JayChintala/1DOF-FOC-Force-Feedback/README.md

# 1DOF-FOC-Force-Feedback
This project aims to use a motor with FOC to find the force applied to it (ie. force feedback). It will then use a second motor to apply an equal force.
