JayChintala/1DOF-FOC-Force-Feedback/BOM.xlsx

ESC | DigiKey | https://www.digikey.com/en/products/detail/stmicroelectronics/B-G431B-ESC1/10321670 | 2 | $39.53 | $79.06
Magnetic Encoder | DigiKey | https://www.digikey.com/en/products/detail/ams-osram-usa-inc/AS5047P-ADAPTERBOARD/5452344 | 2 | $19.40 | $38.80
Motor | RCTimer | https://www.rctimer.com/rctimer-gbm2804-hollow-shaft-brushless-gimbal-motor-p0445.html | 3 | $10.94 | $32.82
USB-CAN Adapter | ODrive | https://shop.odriverobotics.com/products/usb-can-adapter | 1 | $37.00 | $37.00
Magnets | DigiKey | https://www.digikey.com/en/products/detail/radial-magnets-inc/8995/5126077 | 10 | $0.33 | $3.30
12V Power Supply | Amazon | https://www.amazon.com/Towisituati-100V-240V-Converter-Transformer-Connector/dp/B0F4X4J3SL | 1 | $20.00 | $20.00
Tariff Estimate | DigiKey |  | 1 | $18.71 | $18.71
Shipping | DigiKey |  | 1 | $6.99 | $6.99
Shipping + Tariff | ODrive |  | 1 | $14.53 | $14.53
Shipping + Tariff | RCTimer |  | 1 | $17.00 | $17.00
 |  |  |  | Total | $268.21
