JayChintala/1DOF-FOC-Force-Feedback/ESC_based/FIRMWARE_CHANGES.txt

FIRMWARE CHANGES FOR THE DEV MACHINE (ESC_based, both B-G431B-ESC1 boards)
Written 2026-10-25 on the Pi; CHANGE 3 added 2026-10-26.
Repo branch: tune/current-sensing-gain-16x.
Context and test results: ESC_based/software/TEST_LOG.md ("Firmware changes"
section near the top; the B1, "SD-card write stalls" and 2026-10-26 "leader
friction measurements" entries explain why).

===========================================================================
INSTRUCTIONS FOR THE CLAUDE CODE SESSION
===========================================================================

UPDATE 2026-10-28 (Pi, later): 75a893b (CHANGES 3-6) IS FLASHED on both
boards and verified on the bus (CALIB/DIAG present, switching calibration
used). NEXT ROUND = CHANGE 7 (below), same two-phase process.

UPDATE 2026-10-28 (Pi): CHANGES 3-6 are IMPLEMENTED and pushed by the dev
session (856a6bb = CHANGES 1-2 rebased, 75a893b = CHANGES 3-6; both builds
0 warnings). NOT YET FLASHED at the time of writing. Deviation from the
text below, approved by the user: the ch18 phase-C offset is exposed by an
accessor (OffsetCalib_GetPhaseCCh18), PolarizationOffsets_t is unchanged.
Images: Debug/ESC_based.elf (ESC1) sha256 49363e6a..84b6,
Debug_ESC2/ESC_based.elf (ESC2) sha256 72e80386..c23a.

STATUS (2026-10-28): CHANGES 1-3 are ALREADY APPLIED and flashed (1-2 on
2026-10-25, 3 on 2026-10-26; the CHANGE 3 edit is still uncommitted on the
dev machine). Check they are present -- do not apply them twice.

THIS ROUND: CHANGES 4, 5 and 6, in TWO PHASES:
  PHASE 1 (read-only): for CHANGE 5 and CHANGE 6, answer every "CHECK AND
    REPORT FIRST" item and propose the exact design/diff (including any
    MCSDK __weak overrides placed in user code). For CHANGE 4, confirm the
    frame layouts below fit the TX FIFO budget. Then STOP and report to
    the user. Do not edit yet.
  PHASE 2 (after the user approves the report): implement 4, 5 and 6, each
    behind its compile-time switch, build both ESC configurations
    warning-free for the edited files, report the diff + build result, and
    flash only when the user says so.
Do not change anything else.

HARD RULES
- Hand-edit the source files only. NEVER regenerate code from Motor Control
  Workbench / STM32CubeMX. The .ioc (ESC_based/STM32/MCWorkbench/MCWorkbench.ioc)
  still says PGA gain 8x; regenerating would revert the 16x current-sense gain
  and overwrite the hand-written FDCAN and coupling code.
- No other edits, refactors, or "while I'm here" fixes.
- Build both configurations the user flashes (ESC 1 with CAN_NODE_BASE 0x000 and
  ESC 2 with 0x020 -- however the project selects the node base; do not change
  that mechanism). The build must be warning-free for the edited files.
- Do not commit or push unless the user asks. If asked: branch is
  tune/current-sensing-gain-16x; end the commit message with the attribution
  line the user's setup requires.
- When done, report: the diff, build result (errors/warnings), and confirm
  both boards were flashed. The Pi session then verifies on hardware.

All paths below are relative to ESC_based/STM32/MCWorkbench/.

===========================================================================
CHANGE 1 (plan step B4): TELEM sends the 1 ms mean of Iq, not one raw sample
===========================================================================

WHY
The current loop samples Iq at 16 kHz, but TELEM (sent at 1 kHz) carries one
raw sample and discards the other 15. Measured on the Pi: that sample's noise
is 0.030-0.043 A std at rest, and a 16:1 decimation with no anti-alias filter
folds 500 Hz-8 kHz content into 0-500 Hz (a 247 Hz peak in the spectrum is
probably that). The firmware ALREADY accumulates all 16 samples every period
(IqTelem_UpdateHF / IqTelem_GetMeanAndReset in Src/mc_tasks_foc.c, raw s16A
units) and then throws the mean away. A 16-tap boxcar has nulls exactly at
1, 2, 3 ... kHz, where aliasing folds from. Expected: noise >= 2x lower,
aliased peak gone, ~0.5 ms extra delay at most. The TELEM byte layout does
not change, so the Pi needs no change.

FILE: STM32CubeIDE/Application/User/can_driver.c

(a) After the existing #include lines near the top (mc_parameters.h is already
    included there for scaleParams_M1), add:

    /* B4: TELEM Iq = mean of every 16 kHz sample since the previous TELEM
       (IqTelem_GetMeanAndReset, raw s16A, scaled to Amps). 0 = the old raw
       single sample MC_GetIqdMotor1_F().q. */
    #ifndef TELEM_IQ_MEAN
    #define TELEM_IQ_MEAN 1
    #endif

(b) In static void SendTelemetry(const CAN_TickSample_t* s)  (about line 409):

    DELETE this declaration (about line 413):
      qd_f_t iqd = MC_GetIqdMotor1_F(); /* .q = torque-producing current, .d = 0 in
                                           your control scheme */

    REPLACE the comment block and call (about lines 422-430) that begins
      /* The 16 kHz conditioned-Iq accumulator (IqTelem_UpdateHF) is still
    and ends with
      (void)IqTelem_GetMeanAndReset();
    WITH:

      /* The 16 kHz accumulator (IqTelem_UpdateHF) must be drained exactly once
         per telemetry period -- GetMeanAndReset clears it; left uncalled the
         sum grows without bound and loses float precision. With
         TELEM_IQ_MEAN its mean is what TELEM sends (B4): a 16-tap boxcar has
         nulls at 1, 2, 3 ... kHz, exactly where the 1 kHz decimation of the
         raw sample aliased from. It returns the EWMA if no samples accrued
         (HF task not running), so the field never reads as a bogus zero. */
    #if TELEM_IQ_MEAN
      float const iq_tx = IqTelem_GetMeanAndReset() * scaleParams_M1.current;
    #else
      (void)IqTelem_GetMeanAndReset();
      float const iq_tx = MC_GetIqdMotor1_F().q; /* raw single sample */
    #endif

    REPLACE (about line 440):
      memcpy(&payload[0], &iqd.q, sizeof(float));
    WITH:
      memcpy(&payload[0], &iq_tx, sizeof(float));

    Check that nothing else in SendTelemetry() uses `iqd` (it should not).

FILE: Inc/can_driver.h

(c) In the TELEM layout comment (about line 86), change
      [0..3] float32  Iq, Amps (MC_GetIqdMotor1_F().q -- raw, unfiltered)
    to
      [0..3] float32  Iq, Amps: 1 ms mean of the 16 kHz samples when
                      TELEM_IQ_MEAN (default, can_driver.c); raw single
                      sample MC_GetIqdMotor1_F().q when TELEM_IQ_MEAN is 0

===========================================================================
CHANGE 2 (safety): direct-mode host timeout 200 ms -> 20 ms
===========================================================================

WHY
In direct mode the firmware zeroes Iq if no SET_IQ arrives within
COUPLE_DIRECT_TIMEOUT_US. On the Pi, SD-card write stalls froze the host
control loop for up to 2 s (confirmed). During one such freeze the follower's
last command (-0.07 A) stayed applied for the full 200 ms and the free
follower spun 1.8 revolutions; teleop can command up to 1 A. Every ESC_based
host script resends SET_IQ at least every 10 ms (teleop/spin_test/a5 every
2 ms, plant_gain 1 ms, zero_iq_check 10 ms), so 20 ms does not trip in normal
use; a longer stall now zeroes the current (trip HOST_TIMEOUT) and the next
SET_IQ resumes. HOLD/PEER coupling modes have no host timeout and are not
affected.

FILE: Inc/couple_ctrl.h  (about line 113)

    CHANGE
      #define COUPLE_DIRECT_TIMEOUT_US 200000u
    TO
      #define COUPLE_DIRECT_TIMEOUT_US 20000u /* was 200000u; see FIRMWARE_CHANGES.txt */

    Leave the surrounding #ifndef/#endif and the comment above it as they are,
    except: if that comment states 200 ms anywhere, update it to 20 ms.
    (couple_ctrl.c uses the macro at about lines 265-267; no change there.)

===========================================================================
CHANGE 3 (2026-10-26): average the current-sensor offset calibration longer
===========================================================================

WHY
Measured on the Pi with a slow position sweep of the free leader
(friction_map.py): the leader has an angle-locked torque ripple at 7/rev
(once per electrical cycle) of 36 mA in one START and 24 mA, 13 deg shifted,
in the next. Everything else repeated (28/rev 10.1 vs 10.3 mA, friction
17.1 vs 16.8 mA). An electrical-frequency ripple that changes between STARTs
is the signature of a phase-current offset error: MCSDK re-measures the
offsets on every START (correction 2026-10-26 from the dev review: not via
MCI_StartMotor, but the "already calibrated" IDLE branch in mc_tasks_foc.c
still calls R3_2_CurrentReadingPolarization, which re-measures), and it
averages only NB_CONVERSIONS = 16 samples. With the measured 30-43 mA
per-sample noise that leaves roughly +-10 mA of random offset per phase,
new each START. 8x more samples -> about 2.8x smaller offset error.
It is the largest remaining feel defect on the leader (detents every 51 deg,
bigger than the 20 mA felt dead band), and a host-side map cannot cancel it
because it moves every START.

FILE: Inc/pwm_common.h  (line 37)

    CHANGE
      #define NB_CONVERSIONS 16u
    TO
      #define NB_CONVERSIONS 128u /* was 16u: offset calibration averaging; see FIRMWARE_CHANGES.txt CHANGE 3 */

CONSTRAINTS TO CHECK BEFORE BUILDING (report what you find for each)

(a) THE AVERAGING DIVISOR. The offsets are accumulated and divided in the
    R3_2 current-feedback driver, which is NOT in the git repo (MCSDK is
    git-ignored). The project links it from
      MCSDK_v6.4.2-Full/MotorControl/MCSDK/MCLib/G4xx/Src/r3_2_g4xx_pwm_curr_fdbk.c
    (see STM32CubeIDE/.project). Find where PhaseAOffset / PhaseBOffset /
    PhaseCOffset are summed (the HFCurrentsPolarization* functions) and
    where the sum is turned into the offset (CurrentReadingPolarization /
    the end of calibration).
      - If it divides by NB_CONVERSIONS (or by an expression of it), nothing
        else to change.
      - If it divides by a HARD-CODED shift or constant tied to 16 (e.g.
        ">> 4", ">> 3", "/ 16u", or a shift that assumes 16 samples per
        sector pass), STOP and report the exact lines to the user before
        changing anything. Do not guess the new shift: note that 3-shunt
        polarization may sum each phase over two sector passes, so the
        divisor may be 2*NB_CONVERSIONS.
      - Check the accumulator type: with 128 samples of a left-aligned
        16-bit ADC value (up to 65520) the sum reaches about 8.4e6, which
        needs uint32_t / int32_t (fine), not 16 bits. If it is 16-bit, STOP
        and report.
(b) THE COUNTER TYPE. PolarizationCounter is uint8_t (Src/mc_config.c line
    179, and waitForPolarizationEnd(..., volatile uint8_t *cnt) in
    Src/pwm_common.c). So NB_CONVERSIONS must stay <= 255. 128 is fine; do
    NOT use 256.
(c) THE TIMEOUT. Src/pwm_common.c waitForPolarizationEnd computes
      hMaxPeriodsNumber = (2 * NB_CONVERSIONS) * ((repCnt + 1) >> 1)
    as uint16_t. With 128 that is 256 * ((repCnt + 1) >> 1): check repCnt
    (the TIM1 repetition counter used by R3_2) keeps it below 65535 (it
    will unless repCnt is huge). No change expected.
(d) Search the whole build (Src, Inc, STM32CubeIDE/Application, and the
    linked MCSDK sources) for any other use of NB_CONVERSIONS and report it.

EXPECTED SIDE EFFECT
Offset calibration at START takes 8x longer: roughly 2 x 128 PWM periods at
16 kHz, i.e. about 16 ms instead of 2 ms. The Pi scripts wait for RUN, so
nothing on the Pi changes.

===========================================================================
CHANGE 4 (APPLY THIS ROUND -- see STATUS; logged 2026-10-26, frames fixed 2026-10-28)
Diagnostic CAN frames: CALIB (phase offsets) + DIAG (Vqd, sector, flags, NTC), 10 Hz
===========================================================================

WHY
The leader's 7/rev ripple has a fixed phase, grows over time in RUN and
survives a fresh START (TEST_LOG 2026-10-26). Calibration runs with all six
FETs off, while RUN samples mid-period with the low sides conducting.
Reading the offsets and the board NTC back per START, and checking whether
the ripple tracks temperature, separates the two candidate causes: (a) an
offset that exists only while the FETs conduct (calibration cannot see it),
or (b) a thermal offset drift after calibration. The Pi currently works
around the ripple with an in-session calibration sweep; this change is for
root cause. The DIAG frame also diagnoses the measured-Iq breakdown above
~0.5 A (angle-dependent, TEST_LOG 2026-10-28).

WHAT (as described by the dev-session review, 2026-10-26; verify before use)
- Offsets: MC_GetPolarizationOffsetsMotor1(PolarizationOffsets_t*)
  (mc_api.c:693-696). Returns false before the first calibration. Fields are
  int32_t but hold averages of left-aligned 16-bit ADC values, so they fit
  in uint16.
- Temperature: NTC_GetAvTemp_C(&TempSensor_M1) (ntc_temperature_sensor.c:197),
  int16 deg C, board NTC, updated in the safety task.
- FRAME LAYOUTS (fixed 2026-10-28; the Pi parser follows these exactly;
  little-endian like TELEM; transmit-only; outside the 0x20 node block like
  DBG; if a layout must change, report it so the Pi side matches):
  CALIB  ID 0x100 + base + 0x013  (0x113 / 0x133), 10 Hz
    [0..1] u16 offA       [2..3] u16 offB
    [4..5] u16 offC_ch12  [6..7] u16 offC_ch18 (0 when CHANGE 5 is off)
    Raw offsets as used in R3_2_GetPhaseCurrents (left-aligned ADC units).
  DIAG   ID 0x100 + base + 0x014  (0x114 / 0x134), 10 Hz (faster only if
         the TX budget allows; report the rate)
    [0..1] i16 Vqd.q (FOCVars[M1].Vqd.q, after circle limitation)
    [2..3] i16 Vqd.d
    [4]    u8  PWMC _Super.Sector after the sample-point setup
    [5]    u8  flags: bit0 = SECTOR_5 forced this period,
                      bit1 = circle limitation active this period,
                      bit2 = OFFSET_CALIB_SWITCHING (CHANGE 5) built in
    [6..7] i16 board NTC temperature, deg C (NTC_GetAvTemp_C)
  DIAG was added 2026-10-28 for the measured-Iq breakdown above ~0.5 A:
  the dev review called Vqd.q "the most useful single measurement" (a
  lasting shortfall means the Iq PI output hits a limit).
  The two frames can go out on alternate CAN_ControlTick slots (e.g. tick
  % 100 == 0 and == 50) to spread the TX load.
- Send: from CAN_ControlTick (can_driver.c:514), see slots above. The TX
  FIFO has 3 elements and TELEM + DBG use 2 per tick, so count drops the
  same way as s_telemTxDropCount.
- Pi side: a parser in ESC_based/software/can_interface.py (Pi session).
- Same hard rules as above: hand edit only, never regenerate.

===========================================================================
CHANGE 5 (APPLY THIS ROUND, design reported first -- see STATUS; logged 2026-10-28;
apply together with CHANGE 4, behind a compile-time switch)
Offset calibration with the bridge SWITCHING at 50 % duty (zero net current)
===========================================================================

WHY (Pi measurements, TEST_LOG 2026-10-28)
The leader's 7/rev torque ripple (an Iq error at the electrical frequency =
a phase-current offset error) grows while in RUN at ~0 A: 8.9 -> 22.3 mA in
89 s; in a 6 min run 18.5 -> 35 -> 50 -> 61 -> 57 mA, fit
17.6 + 47.9 (1 - e^(-t/160 s)) mA, always along the same phase. A fresh
START on a warm board starts at 18.5 mA (cold: 8.9 mA), so re-calibrating
does NOT remove it. Calibration runs with all six FETs off
(R3_2_CurrentReadingPolarization: LL_TIM_CC_DisableChannel CH1/2/3 + MOE,
OSSR), while RUN samples mid-period with the low-side FETs conducting.
Hypothesis (inferred): an offset that exists only while the bridge
switches and grows with board temperature, invisible to an all-off
calibration. Calibrating under the same switching conditions as RUN, with
equal duty on all three phases (no line-line voltage -> ~0 current), would
capture it. CHANGE 4's readback (offsets + NTC per START) tests this:
with CHANGE 5, a warm START should begin near the cold value, not higher.

WHAT (for the dev session to design and REPORT BEFORE EDITING; MCSDK files
are git-ignored, so record every edit exactly)
- In the R3_2 polarization path (r3_2_g4xx_pwm_curr_fdbk.c, around lines
  476-575 and R3_2_HFCurrentsPolarizationAB/C ~1343/~1392), instead of
  disabling CH1/2/3, program all three compare registers to 50 % of the
  period (Half_PWMPeriod/2 in the center-aligned counter, or whatever gives
  equal duty) and enable the outputs, so the bridge switches exactly as in
  RUN at zero voltage vector; keep the ADC trigger at the RUN mid-period
  point. Restore the normal sequence afterwards.
- Behind  #define OFFSET_CALIB_SWITCHING 1  (0 = stock all-off calibration)
  so it can be rolled back without code edits.
- CHECK AND REPORT FIRST:
  (a) Bootstrap: calibration currently happens BEFORE CHARGE_BOOT_CAP.
      With switching, the high-side drivers need charged bootstrap caps;
      decide whether to run CHARGE_BOOT_CAP first (reorder in
      mc_tasks_foc.c IDLE/OFFSET_CALIB/CHARGE_BOOT_CAP) or rely on the
      low-side on-time. Report the safer sequence.
  (b) Shaft must be still: equal duties give ~0 current only without
      back-EMF. START is only sent with the shaft at rest by the Pi
      scripts; note any firmware guard you would add (e.g. skip
      switching calibration if |speed| > small threshold).
  (c) Dead-time: equal on all three legs, so no net current expected;
      confirm nothing (e.g. sector-dependent sampling in
      R3_2_SetADCSampPointPolarization) breaks with outputs enabled.
  (d) Overcurrent/fault paths stay armed during calibration.
- Same hard rules: hand edit, never regenerate; report the diff and build
  result; do not flash until the user says so.

ADDED 2026-10-28: per-read-path phase-C offset (from the dev review).
Sectors 2-3 read C on ADC2 ch18 (OPAMP3 internal output) but subtract the
PhaseCOffset calibrated on ADC1 ch12 (r3_2.c:714). Fold into CHANGE 5:
calibrate one offset per (ADC, channel, OPAMP-output) path -- a, b, c_ch12,
c_ch18 -- via a third polarization pass with PolarizationSector = SECTOR_2,
using the __weak R3_2_CurrentReadingPolarization / R3_2_GetPhaseCurrents
overrides in user code (MCSDK copy untouched). PolarizationOffsets_t needs
a fourth field for Set/Get.
Pi evidence for this (2026-10-28, hand-held stall steps, TEST_LOG): the
measured-Iq breakdown is ANGLE-dependent -- onset ~0.55 A at electrical
42-67 deg, ~0.8 A at 144/323 deg, none up to 0.8 A at 258 deg (angles
relative to the encoder electrical zero) -- i.e. it tracks the
sector/sampling path, at lower current than the 0.9-1.0 A the review
estimated from Rs 5.29 ohm / 13 V (check the real Vbus and Rs).

VERIFY ON THE PI AFTER FLASHING (with CHANGE 4)
cal_repeat.py --n 5 --wait 60 cold, then again warm right after: with
CHANGE 5 the 7/rev at t=0 of the WARM run should be ~cold value and the
growth within a START smaller; CHANGE 4's NTC trace shows the temperature.

===========================================================================
CHANGE 6 (APPLY THIS ROUND, values reported first -- see STATUS; logged 2026-10-28)
SAFETY: revert the over-current threshold rescaling
===========================================================================

WHY (dev-session review 2026-10-28)
The OCP comparators (COMP1/2/4 vs DAC3, main.c:437-505) compare the OPAMP
INPUTS (PA1/PA7/PB0), i.e. BEFORE the PGA. The "x2 for 8x->16x" rescaling
of DAC_OCP_Threshold (16334, mc_parameters.c:165-168) therefore did not
keep the physical trip current the same -- it RAISED it.

WHAT
Restore DAC_OCP_Threshold to the value that gives the original physical
trip current (the pre-16x value, or recompute from the shunt and the
comparator input network). Report the old value, the new value and the
resulting physical trip current in amps before changing it.

===========================================================================
CHANGE 7 (NEXT ROUND -- approved by the user 2026-10-28; TWO PHASES as before:
report the design first, implement after approval, flash only when told)
Sampling timing for the measured-Iq breakdown above ~0.5 A, plus DIAG fixes
===========================================================================

WHY (Pi measurements on firmware 75a893b, TEST_LOG 2026-10-28)
Hand-held stall steps at a "bad" rotor angle (electrical ~70 deg), with the
new DIAG frame:

  cmd     measured Iq mean (std)   Vq % of full   SECTOR_5 forced (snapshot)
  0.30 A  0.296 (15 mA)            21 %           100 %
  0.45 A  0.443 (18 mA)            29 %           100 %
  0.60 A  0.581 (52 mA)            55 %            71 %
  0.80 A  0.683 (111 mA)           70 %            56 %  (sectors 4, 5)

- The ch18 phase-C offset is now calibrated separately (CALIB shows it
  was 62-76 counts = 114-140 mA off), yet the breakdown is unchanged, and
  at 0.6 A the read is still mostly forced A+B (no ch18). So the ch18
  path is not the cause.
- Vq jumps 29 -> 55 % between 0.45 and 0.6 A (R*I alone: ~39 %): the PI
  over-drives against a measurement that reads low; scale data earlier
  showed the real current overshoots the command (~0.93 A at 0.8 A).
- The breakdown is angle-dependent (onset ~0.55 A at 42-70 deg, ~0.8 A at
  144/323 deg, none to 0.8 A at 258 deg).
- This matches the dev review's sampling-window hypothesis [inferred]: in
  forced SECTOR_5 the A and B samples are taken at Half_PWMPeriod - 1,
  and the time from the highest-duty leg's low-side turn-on to the
  sample shrinks as duty rises (~10 us at 0.45 A, ~7-8 us at 0.68 A real);
  if the sense front end needs longer to settle, the sample reads low.
  It only bites when that highest-duty leg is A or B (sampled), hence the
  angle dependence. The forced-mode test uses Tafter = (750 + 4000 ns) x
  0.17 = 807 counts (parameters_conversion.h:137-140), i.e. it assumes
  ~4.75 us is enough.

WHAT (design to report first)
(a) Make the forced-SECTOR_5 threshold Tafter adjustable WITHOUT
    regenerating: preferably at RUNTIME via a new Pi->MCU CAN command
    (proposed: base+0x007 SET_PARAM, uint8 param id + int32/float value;
    param 1 = Tafter in timer counts, accepted only within e.g. 400..3000
    counts, applied in IDLE or atomically per PWM period -- report which
    is safe), so the Pi can sweep it in one session (stock 807, then e.g.
    ~1360 = 8 us, ~2040 = 12 us) without reflashing. Report whether
    pParams_str->Tafter is const/in flash and what it takes to make it a
    RAM variable used by R3_2_SetADCSampPointSectX (r3_2.c:1134) and any
    other user of Tafter/Tbefore. If a runtime parameter is not
    reasonable, fall back to a compile-time #define SAMPLING_TAFTER_NS
    and report the build matrix.
    Also report: with forced mode ending earlier, which phases does the
    natural-sector path sample (it should be the two lowest-duty legs,
    i.e. longest windows), and is anything else in that path suspect now
    that the ch18 offset is calibrated?
(b) Fix the DIAG flag bits (from Pi data on 75a893b):
    - bit1 "circle limit seen" is set 96-100 % of DIAG frames even at
      0.05 A with Vq ~6 % of full -- impossible; check the |Vqd|^2 test
      (overflow? computed on the wrong variable or including the
      calibration / IDLE periods?).
    - bit3 "non-forced seen" is 100 % at every level while the bit0
      snapshot shows forced 100 %; bit4 "ch18 seen" is 52 % at 0.05 A,
      falling to 0 % at 0.45 A. Check when the sticky bits are set
      (e.g. periods where PWM is on but outside RUN, or the test
      inverted) and fix so they reflect RUN sampling only.
(c) Report the Vq value the PI requests vs the circle-limited Vq (if the
    DIAG Vq is post-limitation, add the pre-limitation value to the spare
    bits or a 3rd frame only if cheap -- optional).
(d) NOT this round, note only: the leader's 7/rev ripple (an Iq error at
    the electrical frequency) still grows in RUN with the switching
    calibration (11 -> 55 mA in 89 s, NTC 34 -> 40 C), so it is most
    likely offset drift with board temperature AFTER calibration. A later
    change could apply offset(T) = offset_cal + k_phase * (NTC - NTC_cal),
    with k measured on the Pi from repeated START/STOP CALIB readbacks.
Same hard rules: hand edits only, never regenerate; compile-time switch
for each part; both builds warning-free; report diff, build result and
image checksums; commit and push after a clean build; do not flash until
the user says so. Report any SET_PARAM layout change so the Pi side
matches.

VERIFY ON THE PI
Stall steps at a bad angle (~70 deg electrical) for each Tafter value,
with DIAG: pass = measured Iq within 2 % of command up to 0.8 A with std
<= 25 mA, Vq roughly proportional to current, SECTOR_5 forced ending
earlier; then the scale check (force linear to 0.8 A at ~1.044 N/A).

===========================================================================
NOT INCLUDED (decided by the user)
===========================================================================
- B5, clamping direct SET_IQ at +-0.8 A, was DROPPED by the user, who says a
  max current is already set. Do not add a clamp.

===========================================================================
AFTER FLASHING (done on the Pi, for reference)
===========================================================================
CHANGE 3: bus_check.py, zero_iq_check.py, then two friction_map.py --node B
sweeps with a START between. Pass: 7/rev amplitude well below 24-36 mA
(target <= 12 mA) and repeatable between the two STARTs (|diff| <= 5 mA);
28/rev and friction unchanged. Then refit leader_comp_B.json, now including
7/rev if it repeats.

Earlier changes (1-2), already verified 2026-10-25:
Both boards will power-cycle, so the Pi's bus_check.py shows RESET. The Pi
session then runs zero_iq_check.py (re-aligns the encoders), and the B4
checks: a 30 s HOLD zero-gain run on the free follower (Iq std >= 2x lower
than 0.030-0.034 A, 247 Hz peak gone) and the A5(c) staircase (50 % step
response <= 2.07 ms). Nothing for the dev-machine session to do there.
