JayChintala/1DOF-FOC-Force-Feedback/electrical-schematic/1DOF_FOC_Force-Feedback.kicad_pcb

## KiCad design c4-taillight-controller/mcu.kicad_sch

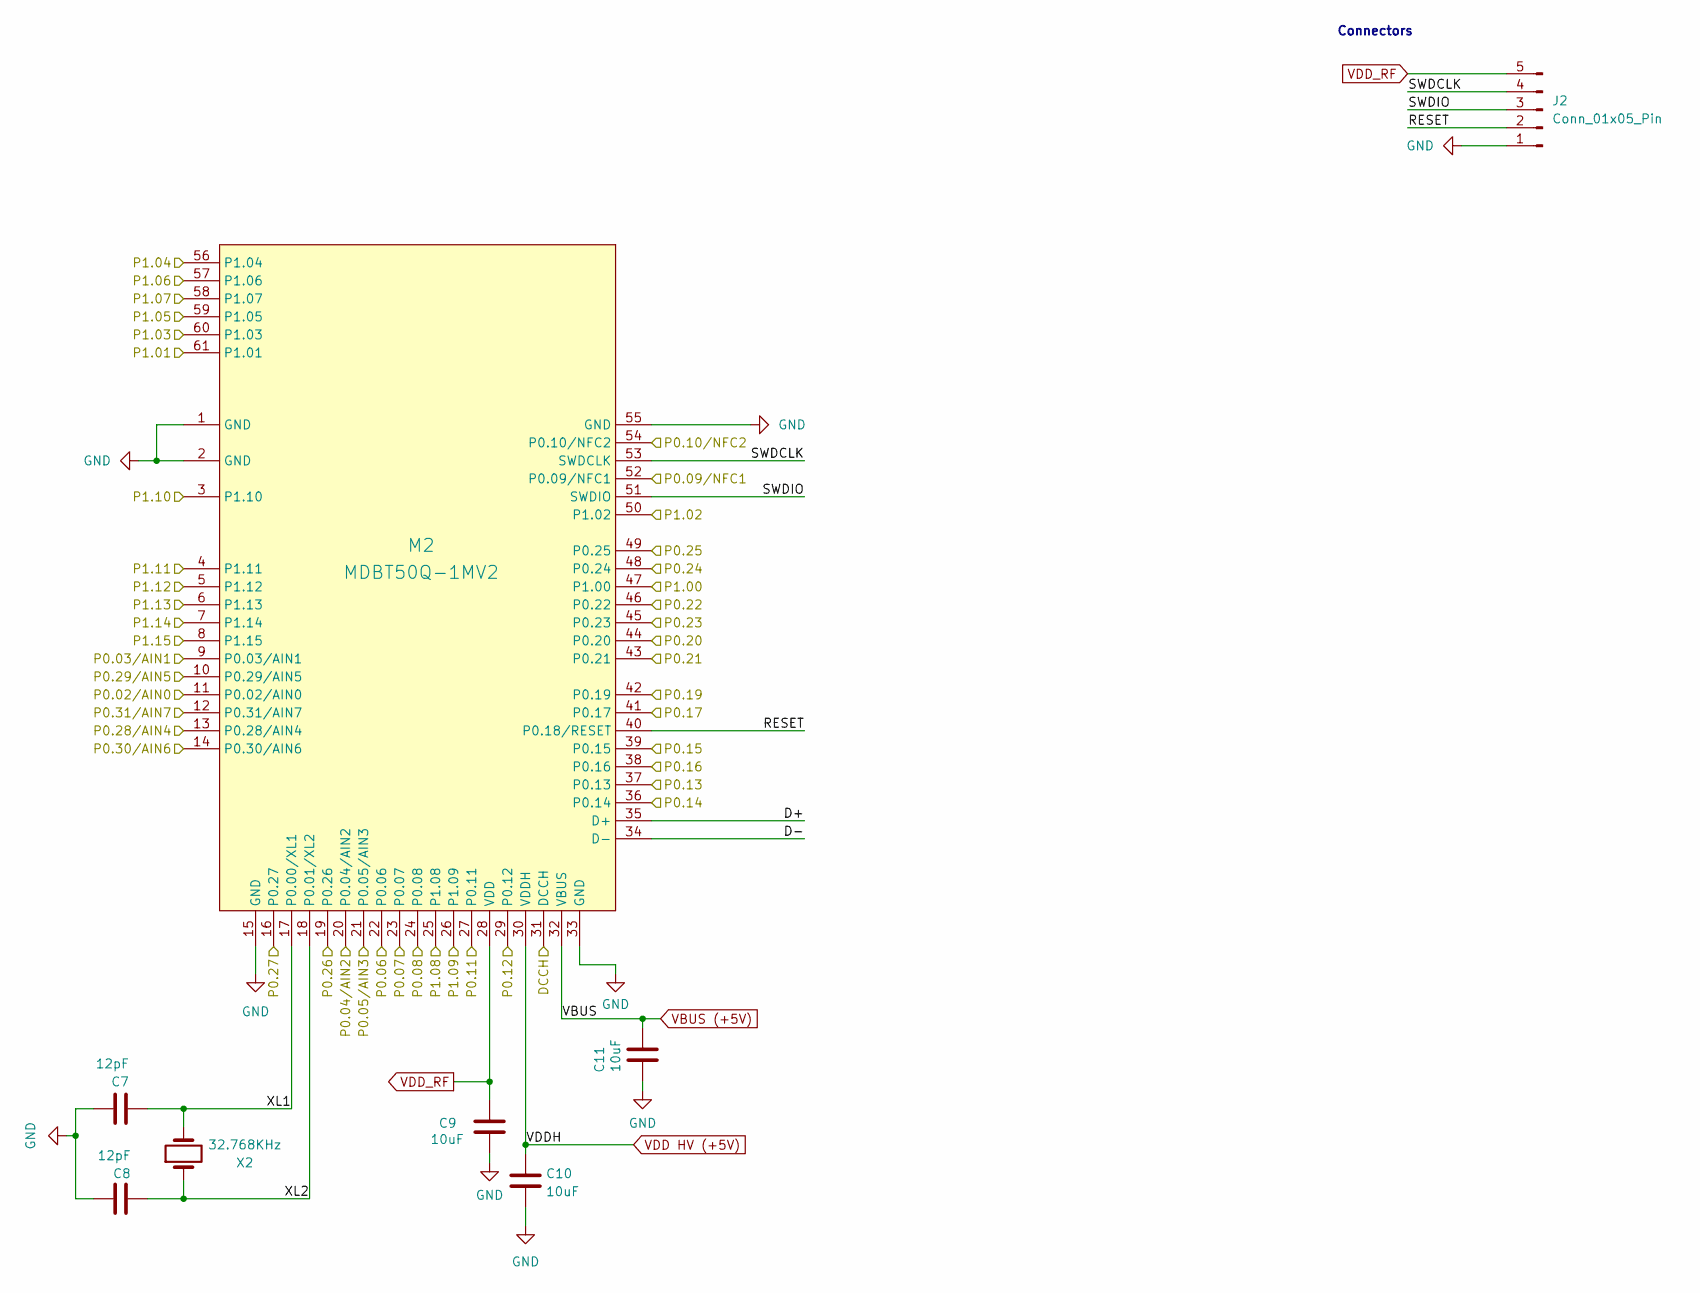
[picture p1: schematic mcu.kicad_sch]

Parts:
C7, C8: 12pF
C9, C10, C11: 10uF
J2: Conn_01x05_Pin
M2: MDBT50Q-1MV2
X2: 32.768KHz

Connections:
D+: M2.35 (D+)
D-: M2.34 (D-)
DCCH: M2.31 (DCCH)
GND: C7.1, C8.1, C9.1, C10.2, C11.1, J2.1, M2.1 (GND), M2.2 (GND), M2.15 (GND), M2.33 (GND), M2.55 (GND)
P0.02/AIN0: M2.11 (P0.02/AIN0)
P0.03/AIN1: M2.9 (P0.03/AIN1)
P0.04/AIN2: M2.20 (P0.04/AIN2)
P0.05/AIN3: M2.21 (P0.05/AIN3)
P0.06: M2.22 (P0.06)
P0.07: M2.23 (P0.07)
P0.08: M2.24 (P0.08)
P0.09/NFC1: M2.52 (P0.09/NFC1)
P0.10/NFC2: M2.54 (P0.10/NFC2)
P0.11: M2.27 (P0.11)
P0.12: M2.29 (P0.12)
P0.13: M2.37 (P0.13)
P0.14: M2.36 (P0.14)
P0.15: M2.39 (P0.15)
P0.16: M2.38 (P0.16)
P0.17: M2.41 (P0.17)
P0.19: M2.42 (P0.19)
P0.20: M2.44 (P0.20)
P0.21: M2.43 (P0.21)
P0.22: M2.46 (P0.22)
P0.23: M2.45 (P0.23)
P0.24: M2.48 (P0.24)
P0.25: M2.49 (P0.25)
P0.26: M2.19 (P0.26)
P0.27: M2.16 (P0.27)
P0.28/AIN4: M2.13 (P0.28/AIN4)
P0.29/AIN5: M2.10 (P0.29/AIN5)
P0.30/AIN6: M2.14 (P0.30/AIN6)
P0.31/AIN7: M2.12 (P0.31/AIN7)
P1.00: M2.47 (P1.00)
P1.01: M2.61 (P1.01)
P1.02: M2.50 (P1.02)
P1.03: M2.60 (P1.03)
P1.04: M2.56 (P1.04)
P1.05: M2.59 (P1.05)
P1.06: M2.57 (P1.06)
P1.07: M2.58 (P1.07)
P1.08: M2.25 (P1.08)
P1.09: M2.26 (P1.09)
P1.10: M2.3 (P1.10)
P1.11: M2.4 (P1.11)
P1.12: M2.5 (P1.12)
P1.13: M2.6 (P1.13)
P1.14: M2.7 (P1.14)
P1.15: M2.8 (P1.15)
RESET: J2.2, M2.40 (P0.18/RESET)
SWDCLK: J2.4, M2.53 (SWDCLK)
SWDIO: J2.3, M2.51 (SWDIO)
VBUS (+5V): C11.2, M2.32 (VBUS)
VDD HV (+5V): C10.1, M2.30 (VDDH)
VDD_RF: C9.2, J2.5, M2.28 (VDD)
XL1: C7.2, M2.17 (P0.00/XL1), X2.2
XL2: C8.2, M2.18 (P0.01/XL2), X2.1

Notes on the sheet:
Connectors
