JayChintala/1DOF-FOC-Force-Feedback/electrical-schematic/1DOF_FOC_Force-Feedback.kicad_pcb

## KiCad design c4-taillight-controller/power.kicad_sch

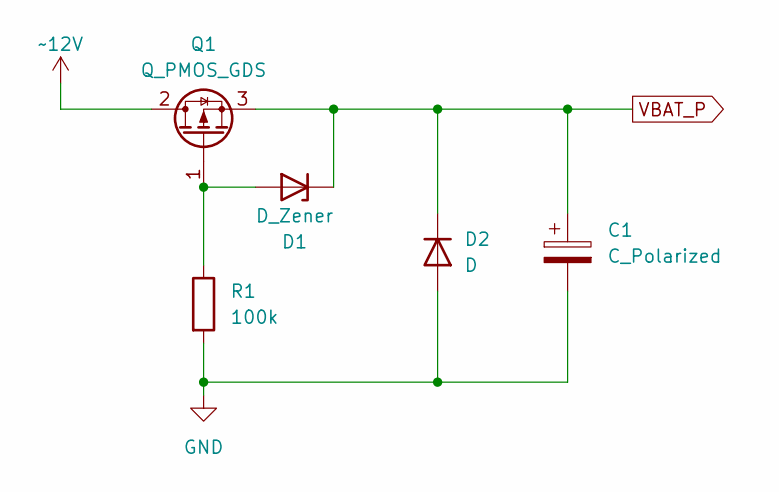
[picture p2: schematic power.kicad_sch]

Parts:
C1: C_Polarized
D1: D_Zener
D2: D
Q1: Q_PMOS_GDS
R1: 100k

Connections:
GND: C1.2, D2.2 (A), R1.2
unnamed: D1.2 (A), Q1.1 (G), R1.1
VBAT_P: C1.1, D1.1 (K), D2.1 (K), Q1.3 (S)
~12V: Q1.2 (D)
