JayChintala/1DOF-FOC-Force-Feedback/ESC_based/STM32/MCWorkbench/MCWorkbench.ioc

Mcu.UserName=STM32G431CBUx
PA0.GPIO_Label=M1_BUS_VOLTAGE
PA0.Signal=ADC1_IN1
PA1.GPIO_Label=M1_CURR_SHUNT_U
PA1.Signal=SharedAnalog_PA1
PA10.GPIO_Label=M1_PWM_WH
PA10.Signal=S_TIM1_CH3
PA11.Signal=FDCAN1_RX
PA12.GPIO_Label=M1_PWM_VL
PA12.Signal=TIM1_CH2N
PA2.GPIO_Label=M1_OPAMP1_OUT
PA2.Signal=SharedAnalog_PA2
PA3.GPIO_Label=M1_OPAMP1_INT_GAIN
PA3.Signal=OPAMP1_VINM0
PA5.GPIO_Label=M1_OPAMP2_INT_GAIN
PA5.Signal=OPAMP2_VINM0
PA6.GPIO_Label=M1_OPAMP2_OUT
PA6.Signal=SharedAnalog_PA6
PA7.GPIO_Label=M1_CURR_SHUNT_V
PA7.Signal=SharedAnalog_PA7
PA8.GPIO_Label=M1_PWM_UH
PA8.Signal=S_TIM1_CH1
PA9.GPIO_Label=M1_PWM_VH
PA9.Signal=S_TIM1_CH2
PB0.GPIO_Label=M1_CURR_SHUNT_W
PB0.Signal=SharedAnalog_PB0
PB1.GPIO_Label=M1_OPAMP3_OUT
PB1.Signal=SharedAnalog_PB1
PB13.GPIO_Label=CAN_TERM_ALT
PB13.Signal=GPIO_Output
PB14.GPIO_Label=M1_TEMPERATURE
PB14.Signal=ADC1_IN5
PB15.GPIO_Label=M1_PWM_WL
PB15.Signal=TIM1_CH3N
PB2.GPIO_Label=M1_OPAMP3_INT_GAIN
PB2.Signal=OPAMP3_VINM0
PB3.GPIO_Label=UART_TX
PB3.Signal=USART2_TX
PB4.GPIO_Label=UART_RX
PB4.Signal=USART2_RX
PB6.GPIO_Label=M1_ENCODER_A
PB6.Signal=S_TIM4_CH1
PB7.GPIO_Label=M1_ENCODER_B
PB7.Signal=S_TIM4_CH2
PB9.Signal=FDCAN1_TX
PC10.GPIO_Label=Start/Stop [PushButton]
PC10.Signal=GPXTI10
PC11.GPIO_Label=CAN_SHDN
PC11.Signal=GPIO_Output
PC13.Signal=TIM1_CH1N
PC14-OSC32_IN.GPIO_Label=CAN_TERM
PC14-OSC32_IN.Signal=GPIO_Output
PF0-OSC_IN.Signal=RCC_OSC_IN
PF1-OSC_OUT.Signal=RCC_OSC_OUT
