JayChintala/1DOF-FOC-Force-Feedback/ESC_based/STM32/MCWorkbench/Src/mc_tasks_foc.c

/**
  ******************************************************************************
  * @file    mc_tasks_foc.c
  * @author  Motor Control SDK Team, ST Microelectronics
  * @brief   This file implements tasks definition
  *
  ******************************************************************************
  * @attention
  *
  * <h2><center>&copy; Copyright (c) 2026 STMicroelectronics.
  * All rights reserved.</center></h2>
  *
  * This software component is licensed by ST under Ultimate Liberty license
  * SLA0044, the "License"; You may not use this file except in compliance with
  * the License. You may obtain a copy of the License at:
  *                             www.st.com/SLA0044
  *
  ******************************************************************************
  * @ingroup MCTasksFOC
  */

/* Includes ------------------------------------------------------------------*/
//cstat -MISRAC2012-Rule-21.1
#include "main.h"
//cstat +MISRAC2012-Rule-21.1
#include "mc_type.h"
#include "mc_math.h"
#include "motorcontrol.h"
#include "regular_conversion_manager.h"
#include "mc_interface.h"
#include "digital_output.h"
#include "pwm_common.h"
#include "mc_tasks.h"
#include "parameters_conversion.h"
#include "mcp_config.h"
#include "mc_app_hooks.h"

/** @addtogroup MCSDK
  * @{
  */

 /** @defgroup ConvFOC Conventional FOC
  *
  * @brief
  *
  * @{
  */

  /** @defgroup MCCockpit MC Cockpit
  *
  * @brief
  *
  * @{
  */

/** @addtogroup ConvFOC
  * @{
  */

/** @addtogroup	MCCockpit
  * @{
  */

/** @addtogroup	MCTasksFOC
  * @{
  */

/** @defgroup MCTasksFOC Motor Control Tasks for FOC
  *
  * @brief FOC legacy Motor Control subsystem configuration and operation routines.
  *
  * @{
  */

/* USER CODE BEGIN Private define */

/* USER CODE END Private define */


static volatile uint16_t hBootCapDelayCounterM1 = ((uint16_t)0);
static volatile uint16_t hStopPermanencyCounterM1 = ((uint16_t)0);

/* USER CODE BEGIN Private Variables */

/* ---- Iq telemetry conditioning (FLASH 1: telemetry only) ------------------
 * Fed from FOC_HighFrequencyTask at 16 kHz, drained by CAN_SendTelemetry()
 * at 1 kHz (SPEED_LOOP_FREQUENCY_HZ). Nothing here feeds the current PI
 * loop: FOCVars[M1].Iqd is read, never written, so control behaviour is
 * bit-for-bit unchanged. This exists to make the CAN telemetry a trustworthy
 * instrument before any control change is attempted.
 *
 * WHY: CAN_SendTelemetry() samples the 16 kHz Iq once per millisecond and
 * drops the other 15 samples. That is a 16:1 decimation with no anti-alias
 * filter, so everything from 500 Hz to 8 kHz folds down into the 0-500 Hz
 * band being plotted. Two conditioned variants are published alongside the
 * untouched raw sample so the three can be compared in a single run:
 *
 *   EWMA  - single pole, alpha 0.05, -3 dB at ~131 Hz. Matches PropHand's
 *           ALPHA_CURRENT_DQ. This is the variant worth promoting into the
 *           control loop later; only ~-12 dB at the 500 Hz fold point.
 *   MEAN  - boxcar average of every sample since the last telemetry send.
 *           A 16-tap boxcar has nulls at exactly 1 kHz, 2 kHz, ... which is
 *           precisely where aliasing folds from, so this is the better
 *           instrument for answering "is the noise real or aliased?".
 *
 * Units are raw s16A (same as FOCVars[].Iqd.q); can_driver.c scales to Amps
 * via scaleParams_M1.current so there is no second place to update when
 * AMPLIFICATION_GAIN changes. */
#define IQ_TELEM_EWMA_ALPHA 0.05f

static volatile float    s_iqTelemEwma     = 0.0f;
static volatile float    s_iqTelemAccum    = 0.0f;
static volatile uint32_t s_iqTelemAccumCnt = 0u;

/* ---- DIAG frame snapshot (CHANGE 4, FIRMWARE_CHANGES.txt) ------------------
 * Written at 16 kHz by Diag_UpdateHF() right after FOC_CurrControllerM1(),
 * drained by can_driver.c's DIAG send (10 Hz). Telemetry only: nothing here
 * is read by the control loop. Vqd is packed into one word so the 1 kHz
 * reader can never pair a q from one cycle with a d from another. */
#include "can_driver.h" /* CAN_DIAG_FLAG_*, CAN_DiagSample_t */
#include "sampling_tafter.h" /* CHANGE 7(a): the sampling callback and Tafter in use */

#if SAMPLING_TAFTER_RUNTIME
#define DIAG_SAMPLING_CB (&Sampling_SetADCSampPointSectX)
#else
#define DIAG_SAMPLING_CB (&R3_2_SetADCSampPointSectX)
#endif

static volatile uint32_t s_diagVqd    = 0u; /* Vqd.q in bits 0..15, Vqd.d in 16..31 */
static volatile uint8_t  s_diagSector = 0u;
static volatile uint8_t  s_diagFlags  = 0u; /* CAN_DIAG_FLAG_* bits 0, 1, 3, 4 */

#if CAN_DIAG2_FRAME
/* CHANGE 7(c): DIAG2. s_diagVqReq is the Iq PI output BEFORE circle
   limitation, stored by the one-line hand edit in FOC_CurrControllerM1().
   The counts are RUN periods since the previous DIAG2, saturating. */
static volatile int16_t  s_diagVqReq        = 0;
static volatile uint16_t s_diag2CircleCnt   = 0u;
static volatile uint16_t s_diag2NonForcedCnt = 0u;
#endif

/* USER CODE END Private Variables */

void TSK_MediumFrequencyTaskM1(void);
void FOC_InitAdditionalMethods(uint8_t bMotor);
void FOC_CalcCurrRef(uint8_t bMotor);
void TSK_MF_StopProcessing(uint8_t motor);

MCI_Handle_t *GetMCI(uint8_t bMotor);
static uint16_t FOC_CurrControllerM1(void);

void TSK_SafetyTask_PWMOFF(uint8_t motor);

/* USER CODE BEGIN Private Functions */

/* Declared in can_driver.h -- see the note there about why the telemetry
 * accessors are declared by the consumer rather than by a header of their
 * own (avoiding a new source file that would need adding to the build). */

/* Called from FOC_HighFrequencyTask at 16 kHz, after FOC_CurrControllerM1()
 * has published FOCVars[M1].Iqd. Runs in the ADC ISR: keep it branch-free
 * and FPU-only. */
void IqTelem_UpdateHF(int16_t iq_s16)
{
  float const iq = (float)iq_s16;

  /* Local read-modify-write so the volatile is touched once each way. */
  float ewma = s_iqTelemEwma;
  ewma += IQ_TELEM_EWMA_ALPHA * (iq - ewma);
  s_iqTelemEwma = ewma;

  s_iqTelemAccum    = s_iqTelemAccum + iq;
  s_iqTelemAccumCnt = s_iqTelemAccumCnt + 1u;
}

/* Single aligned 32-bit load -- atomic against the ISR on Cortex-M4, so no
 * masking needed here. */
float IqTelem_GetEwma(void)
{
  return s_iqTelemEwma;
}

/* Sum and count must be snapshotted and cleared together, so this one does
 * need the ISR held off. Costs the HF task a few cycles of jitter at 1 kHz.
 * Returns the EWMA if no samples accrued (motor stopped, HF task not
 * running) so the field never reads as a bogus zero. */
float IqTelem_GetMeanAndReset(void)
{
  uint32_t const primask = __get_PRIMASK();
  __disable_irq();

  float    const sum = s_iqTelemAccum;
  uint32_t const cnt = s_iqTelemAccumCnt;
  s_iqTelemAccum    = 0.0f;
  s_iqTelemAccumCnt = 0u;

  __set_PRIMASK(primask);

  return (cnt > 0u) ? (sum / (float)cnt) : s_iqTelemEwma;
}

/* Called from FOC_HighFrequencyTask at 16 kHz, after FOC_CurrControllerM1()
 * has run PWMC_SetPhaseVoltage(), so _Super.Sector is the read path the
 * NEXT period's R3_2_GetPhaseCurrents() will use. The path flags are only
 * updated while the normal sampling callback is installed with the PWM on,
 * i.e. not during offset calibration (which forces its own sectors). */
void Diag_UpdateHF(void)
{
  qd_t const v = FOCVars[M1].Vqd;
  s_diagVqd = (uint32_t)(uint16_t)v.q | ((uint32_t)(uint16_t)v.d << 16);

  PWMC_R3_2_Handle_t const *const h = &PWM_Handle_M1;
  bool const sampling = h->_Super.PWMState &&
      (h->_Super.pFctSetADCSampPointSectX == DIAG_SAMPLING_CB);
  /* CHANGE 7(b): PWM-on periods outside RUN (encoder ALIGNMENT on the first
     START after reset) no longer reach the flags. */
  bool const run = (RUN == Mci[M1].State);
#if DIAG_FLAGS_RUN_ONLY
  bool const flagsOn = sampling && run;
#else
  bool const flagsOn = sampling;
#endif

  if (sampling)
  {
    /* The exact test the sampling callback just made. */
    bool const forced =
        (uint16_t)(h->Half_PWMPeriod - h->_Super.lowDuty) > Sampling_GetTafter();

    /* Circle_Limitation() puts a limited vector on the circle, short only by
       its integer square-root truncation, so |Vqd|^2 >= M^2 - 2M catches
       every limited period (and only vectors within ~1 LSB of the circle
       otherwise). */
    int32_t const m = (int32_t)CircleLimitationM1.MaxModule;
    int32_t const sq = ((int32_t)v.q * v.q) + ((int32_t)v.d * v.d);
    bool const limited = (sq >= ((m * m) - (2 * m)));

    if (flagsOn)
    {
      uint8_t const sector = h->_Super.Sector;
      /* bit0 is a snapshot of this period; the others are sticky. */
      uint8_t f = s_diagFlags & (uint8_t)~CAN_DIAG_FLAG_SECTOR5_FORCED;
      f |= forced ? CAN_DIAG_FLAG_SECTOR5_FORCED : CAN_DIAG_FLAG_NONFORCED_SEEN;
      if ((SECTOR_2 == sector) || (SECTOR_3 == sector))
      {
        f |= CAN_DIAG_FLAG_CH18_SEEN;
      }
      if (limited)
      {
        f |= CAN_DIAG_FLAG_CIRCLE_SEEN;
      }
      s_diagSector = sector;
      s_diagFlags = f;
    }

#if CAN_DIAG2_FRAME
    /* DIAG2 counts RUN periods only, whatever DIAG_FLAGS_RUN_ONLY says. */
    if (run)
    {
      if (limited && (s_diag2CircleCnt < UINT16_MAX))
      {
        s_diag2CircleCnt++;
      }
      if (!forced && (s_diag2NonForcedCnt < UINT16_MAX))
      {
        s_diag2NonForcedCnt++;
      }
    }
#endif
  }
}

#if CAN_DIAG2_FRAME
/* Snapshot for the DIAG2 frame; clears the counts, so call it exactly once
 * per DIAG2. */
void Diag2_GetAndReset(CAN_Diag2Sample_t *out)
{
  uint32_t const primask = __get_PRIMASK();
  __disable_irq();

  out->vq_req = s_diagVqReq;
  out->circle_cnt = s_diag2CircleCnt;
  out->nonforced_cnt = s_diag2NonForcedCnt;
  s_diag2CircleCnt = 0u;
  s_diag2NonForcedCnt = 0u;

  __set_PRIMASK(primask);
}
#endif

/* Snapshot for the DIAG frame; clears the sticky flags, so it must be called
 * exactly once per DIAG. Holds the ISR off for a few cycles. */
void Diag_GetAndReset(CAN_DiagSample_t *out)
{
  uint32_t const primask = __get_PRIMASK();
  __disable_irq();

  uint32_t const vqd = s_diagVqd;
  out->sector = s_diagSector;
  out->flags = s_diagFlags;
  s_diagFlags = 0u;

  __set_PRIMASK(primask);

  out->vq = (int16_t)(uint16_t)(vqd & 0xFFFFu);
  out->vd = (int16_t)(uint16_t)(vqd >> 16);
}

/* USER CODE END Private Functions */
/**
  * @brief  It initializes the whole MC core according to user defined
  *         parameters.
  */
__weak void FOC_Init(void)
{

    /**********************************************************/
    /*    PWM and current sensing component initialization    */
    /**********************************************************/
    pwmcHandle[M1] = &PWM_Handle_M1._Super;
    R3_2_Init(&PWM_Handle_M1);

    /******************************************************/
    /*   PID component initialization: speed regulation   */
    /******************************************************/
    PID_HandleInit(&PIDSpeedHandle_M1);

    /******************************************************/
    /*   Main speed sensor component initialization       */
    /******************************************************/
    ENC_Init (&ENCODER_M1);

    /******************************************************/
    /*   Main encoder alignment component initialization  */
    /******************************************************/
    EAC_Init(&EncAlignCtrlM1,pSTC[M1],&VirtualSpeedSensorM1,&ENCODER_M1);
    pEAC[M1] = &EncAlignCtrlM1;

    /******************************************************/
    /*   Speed & torque component initialization          */
    /******************************************************/
    STC_Init(pSTC[M1],&PIDSpeedHandle_M1, &ENCODER_M1._Super);

    /********************************************************/
    /*   PID component initialization: current regulation   */
    /********************************************************/
    PID_HandleInit(&PIDIqHandle_M1);
    PID_HandleInit(&PIDIdHandle_M1);

    /*************************************************/
    /*   Power measurement component initialization  */
    /*************************************************/
    pMPM[M1]->pVBS = &(BusVoltageSensor_M1._Super);
    pMPM[M1]->pFOCVars = &FOCVars[M1];

    pREMNG[M1] = &RampExtMngrHFParamsM1;
    REMNG_Init(pREMNG[M1]);

    FOC_Clear(M1);
    STC_Clear(pSTC[M1]);
    FOCVars[M1].bDriveInput = EXTERNAL;
    FOCVars[M1].Iqdref = STC_GetDefaultIqdref(pSTC[M1]);
    FOCVars[M1].UserIdref = STC_GetDefaultIqdref(pSTC[M1]).d;

    MCI_ExecTorqueRamp(&Mci[M1], STC_GetDefaultIqdref(pSTC[M1]).q, 0);

}

/**
 * @brief Performs stop process and update the state machine.This function
 *        shall be called only during medium frequency task.
 */
void TSK_MF_StopProcessing(uint8_t motor)
{
  R3_2_SwitchOffPWM(pwmcHandle[motor]);

  FOC_Clear(motor);
  STC_Clear(pSTC[motor]);

  TSK_SetStopPermanencyTimeM1(STOPPERMANENCY_TICKS);
  Mci[motor].State = STOP;
}

/**
  * @brief Executes medium frequency periodic Motor Control tasks
  *
  * This function performs some of the control duties on Motor 1 according to the
  * present state of its state machine. In particular, duties requiring a periodic
  * execution at a medium frequency rate (such as the speed controller for instance)
  * are executed here.
  */
__weak void TSK_MediumFrequencyTaskM1(void)
{
  int16_t wAux = 0;
  (void)ENC_CalcAvrgMecSpeedUnit(&ENCODER_M1, &wAux);
  PQD_CalcElMotorPower(pMPM[M1]);

  if (MCI_GetCurrentFaults(&Mci[M1]) == MC_NO_FAULTS)
  {
    if (MCI_GetOccurredFaults(&Mci[M1]) == MC_NO_FAULTS)
    {
      switch (Mci[M1].State)
      {

        case IDLE:
        {
          if ((MCI_START == Mci[M1].DirectCommand) || (MCI_MEASURE_OFFSETS == Mci[M1].DirectCommand))
          {
            if (pwmcHandle[M1]->offsetCalibStatus == false)
            {
              (void)PWMC_CurrentReadingCalibr(pwmcHandle[M1], CRC_START);
              Mci[M1].State = OFFSET_CALIB;
            }
            else
            {
              /* Calibration already done. Enables only TIM channels */
              pwmcHandle[M1]->OffCalibrWaitTimeCounter = 1u;
              (void)PWMC_CurrentReadingCalibr(pwmcHandle[M1], CRC_EXEC);

              R3_2_TurnOnLowSides(pwmcHandle[M1],M1_CHARGE_BOOT_CAP_DUTY_CYCLES);
              TSK_SetChargeBootCapDelayM1(M1_CHARGE_BOOT_CAP_TICKS);
              Mci[M1].State = CHARGE_BOOT_CAP;
            }
          }
          else
          {
            /* Nothing to be done, FW stays in IDLE state */
          }
          break;
        }

        case OFFSET_CALIB:
        {
          if (MCI_STOP == Mci[M1].DirectCommand)
          {
            TSK_MF_StopProcessing(M1);
          }
          else
          {
            if (PWMC_CurrentReadingCalibr(pwmcHandle[M1], CRC_EXEC))
            {
              if (MCI_MEASURE_OFFSETS == Mci[M1].DirectCommand)
              {
                FOC_Clear(M1);
                STC_Clear(pSTC[M1]);
                Mci[M1].DirectCommand = MCI_NO_COMMAND;
                Mci[M1].State = IDLE;
              }
              else
              {
                R3_2_TurnOnLowSides(pwmcHandle[M1],M1_CHARGE_BOOT_CAP_DUTY_CYCLES);
                TSK_SetChargeBootCapDelayM1(M1_CHARGE_BOOT_CAP_TICKS);
                Mci[M1].State = CHARGE_BOOT_CAP;
              }
            }
            else
            {
              /* Nothing to be done, FW waits for offset calibration to finish */
            }
          }
          break;
        }

        case CHARGE_BOOT_CAP:
        {
          if (MCI_STOP == Mci[M1].DirectCommand)
          {
            TSK_MF_StopProcessing(M1);
          }
          else
          {
            if (TSK_ChargeBootCapDelayHasElapsedM1())
            {
              R3_2_SwitchOffPWM(pwmcHandle[M1]);
              FOCVars[M1].bDriveInput = EXTERNAL;
              STC_SetSpeedSensor( pSTC[M1], &VirtualSpeedSensorM1._Super );

              ENC_Clear(&ENCODER_M1);

              FOC_Clear( M1 );

              if (EAC_IsAligned(&EncAlignCtrlM1) == false)
              {
                EAC_StartAlignment(&EncAlignCtrlM1);
                Mci[M1].State = ALIGNMENT;
              }
              else
              {
                STC_SetControlMode(pSTC[M1], MCM_SPEED_MODE);
                STC_SetSpeedSensor(pSTC[M1], &ENCODER_M1._Super);
                FOC_InitAdditionalMethods(M1);
                FOC_CalcCurrRef(M1);
                STC_ForceSpeedReferenceToCurrentSpeed(pSTC[M1]); /* Init the reference speed to current speed */
                MCI_ExecBufferedCommands(&Mci[M1]); /* Exec the speed ramp after changing of the speed sensor */
                Mci[M1].State = RUN;
              }
              PWMC_SwitchOnPWM(pwmcHandle[M1]);
            }
            else
            {
              /* Nothing to be done, FW waits for bootstrap capacitor to charge */
            }
          }
          break;
        }

        case ALIGNMENT:
        {
          if (MCI_STOP == Mci[M1].DirectCommand)
          {
            TSK_MF_StopProcessing(M1);
          }
          else
          {
            bool isAligned = EAC_IsAligned(&EncAlignCtrlM1);
            bool EACDone = EAC_Exec(&EncAlignCtrlM1);
            if ((isAligned == false)  && (EACDone == false))
            {
              qd_t IqdRef;
              IqdRef.q = 0;
              IqdRef.d = STC_CalcTorqueReference(pSTC[M1]);
              FOCVars[M1].Iqdref = IqdRef;
            }
            else
            {
              R3_2_SwitchOffPWM( pwmcHandle[M1] );
              STC_Clear(pSTC[M1]);
              STC_SetControlMode(pSTC[M1], MCM_SPEED_MODE);
              STC_SetSpeedSensor(pSTC[M1], &ENCODER_M1._Super);
              FOC_Clear(M1);
              R3_2_TurnOnLowSides(pwmcHandle[M1],M1_CHARGE_BOOT_CAP_DUTY_CYCLES);
              TSK_SetStopPermanencyTimeM1(STOPPERMANENCY_TICKS);
              Mci[M1].State = WAIT_STOP_MOTOR;
              /* USER CODE BEGIN MediumFrequencyTask M1 EndOfEncAlignment */

              /* USER CODE END MediumFrequencyTask M1 EndOfEncAlignment */
            }
          }
          break;
        }

        case RUN:
        {
          if (MCI_STOP == Mci[M1].DirectCommand)
          {
            TSK_MF_StopProcessing(M1);
          }
          else
          {
            MCI_ExecBufferedCommands(&Mci[M1]);

              FOC_CalcCurrRef(M1);
          }
          break;
        }

        case STOP:
        {
          if (TSK_StopPermanencyTimeHasElapsedM1())
          {

            Mci[M1].DirectCommand = MCI_NO_COMMAND;
            Mci[M1].State = IDLE;
          }
          else
          {
            /* Nothing to do, FW waits for to stop */
          }
          break;
        }

        case FAULT_OVER:
        {
          if (MCI_ACK_FAULTS == Mci[M1].DirectCommand)
          {
            Mci[M1].DirectCommand = MCI_NO_COMMAND;
            Mci[M1].State = IDLE;
          }
          else
          {
            /* Nothing to do, FW stays in FAULT_OVER state until acknowledgement */
          }
          break;
        }

        case FAULT_NOW:
        {
          Mci[M1].State = FAULT_OVER;
          break;
        }

        case WAIT_STOP_MOTOR:
        {
          if (MCI_STOP == Mci[M1].DirectCommand)
          {
            TSK_MF_StopProcessing(M1);
          }
          else
          {
            if (TSK_StopPermanencyTimeHasElapsedM1())
            {
              ENC_Clear(&ENCODER_M1);
              R3_2_SwitchOnPWM(pwmcHandle[M1]);
              FOC_InitAdditionalMethods(M1);
              STC_ForceSpeedReferenceToCurrentSpeed(pSTC[M1]); /* Init the reference speed to current speed */
              MCI_ExecBufferedCommands(&Mci[M1]); /* Exec the speed ramp after changing of the speed sensor */
              FOC_CalcCurrRef(M1);
              Mci[M1].State = RUN;
            }
            else
            {
              /* Nothing to do */
            }
          }
          break;
        }

        default:
          break;
       }
    }
    else
    {
      Mci[M1].State = FAULT_OVER;
    }
  }
  else
  {
    Mci[M1].State = FAULT_NOW;
  }
}

/**
  * @brief  It re-initializes the current and voltage variables. Moreover
  *         it clears qd currents PI controllers, voltage sensor and SpeednTorque
  *         controller. It must be called before each motor restart.
  *         It does not clear speed sensor.
  * @param  bMotor related motor it can be M1 or M2.
  */
__weak void FOC_Clear(uint8_t bMotor)
{
  ab_t NULL_ab = {((int16_t)0), ((int16_t)0)};
  qd_t NULL_qd = {((int16_t)0), ((int16_t)0)};
  alphabeta_t NULL_alphabeta = {((int16_t)0), ((int16_t)0)};

  FOCVars[bMotor].Iab = NULL_ab;
  FOCVars[bMotor].Ialphabeta = NULL_alphabeta;
  FOCVars[bMotor].Iqd = NULL_qd;
    FOCVars[bMotor].Iqdref = NULL_qd;
  FOCVars[bMotor].hTeref = (int16_t)0;
  FOCVars[bMotor].Vqd = NULL_qd;
  FOCVars[bMotor].Valphabeta = NULL_alphabeta;
  FOCVars[bMotor].hElAngle = (int16_t)0;

  PID_SetIntegralTerm(pPIDIq[bMotor], ((int32_t)0));
  PID_SetIntegralTerm(pPIDId[bMotor], ((int32_t)0));

  PWMC_SwitchOffPWM(pwmcHandle[bMotor]);

}

/**
  * @brief  Use this method to initialize additional methods (if any) in
  *         START_TO_RUN state.
  * @param  bMotor related motor it can be M1 or M2.
  */
__weak void FOC_InitAdditionalMethods(uint8_t bMotor) //cstat !RED-func-no-effect
{
    if (M_NONE == bMotor)
    {
      /* Nothing to do */
    }
    else
    {
    }
}

/**
  * @brief  It computes the new values of Iqdref (current references on qd
  *         reference frame) based on the required electrical torque information
  *         provided by oTSC object (internally clocked).
  *         If implemented in the derived class it executes flux weakening and/or
  *         MTPA algorithm(s). It must be called with the periodicity specified
  *         in oTSC parameters.
  * @param  bMotor related motor it can be M1 or M2.
  */
__weak void FOC_CalcCurrRef(uint8_t bMotor)
{
  qd_t IqdTmp;

  /* Enter critical section */
  /* Disable interrupts to avoid any interruption during Iqd reference latching */
  /* to avoid MF task writing them while HF task reading them */
  __disable_irq();
  IqdTmp = FOCVars[bMotor].Iqdref;

  /* Exit critical section */
  __enable_irq();

  if (INTERNAL == FOCVars[bMotor].bDriveInput)
  {
    FOCVars[bMotor].hTeref = STC_CalcTorqueReference(pSTC[bMotor]);
    IqdTmp.q = FOCVars[bMotor].hTeref;

  }
  else
  {
    /* Nothing to do */
  }

  /* Enter critical section */
  /* Disable interrupts to avoid any interruption during Iqd reference restoring */
  __disable_irq();
  FOCVars[bMotor].Iqdref = IqdTmp;

  /* Exit critical section */
  __enable_irq();
}

#if defined (CCMRAM)
#if defined (__ICCARM__)
#pragma location = ".ccmram"
#elif defined (__CC_ARM) || defined(__GNUC__)
__attribute__((section (".ccmram")))
#endif
#endif

/**
  * @brief  Executes the Motor Control duties that require a high frequency rate and a precise timing.
  *
  *  This is mainly the FOC current control loop. It is executed depending on the state of the Motor Control
  * subsystem (see the state machine(s)).
  * @param bMotorNbr Motor reference number defined
  * @retval Number of the  motor instance which FOC loop was executed.
  */
__weak uint8_t FOC_HighFrequencyTask(uint8_t bMotorNbr)
{
  uint16_t hFOCreturn;
  RCM_ReadOngoingConv();
  RCM_ExecNextConv();

  (void)ENC_CalcAngle(&ENCODER_M1);   /* If not sensorless then 2nd parameter is MC_NULL */

  /* USER CODE BEGIN HighFrequencyTask SINGLEDRIVE_1 */

  /* USER CODE END HighFrequencyTask SINGLEDRIVE_1 */
  hFOCreturn = FOC_CurrControllerM1();
  /* USER CODE BEGIN HighFrequencyTask SINGLEDRIVE_2 */

  /* FOC_CurrControllerM1() has just stored FOCVars[M1].Iqd, so this sees the
   * current cycle's value. Telemetry conditioning only -- does not write
   * back into FOCVars, so the PI controllers are unaffected. */
  IqTelem_UpdateHF(FOCVars[M1].Iqd.q);
#if CAN_DIAG_FRAMES
  Diag_UpdateHF(); /* DIAG frame snapshot (CHANGE 4), telemetry only */
#endif

  /* USER CODE END HighFrequencyTask SINGLEDRIVE_2 */
  if(hFOCreturn == MC_DURATION)
  {
    MCI_FaultProcessing(&Mci[M1], MC_DURATION, 0);
  }
  else
  {
    /* USER CODE BEGIN HighFrequencyTask SINGLEDRIVE_3 */

    /* USER CODE END HighFrequencyTask SINGLEDRIVE_3 */
  }

  return (bMotorNbr);

}

#if defined (CCMRAM)
#if defined (__ICCARM__)
#pragma location = ".ccmram"
#elif defined (__CC_ARM) || defined(__GNUC__)
__attribute__((section (".ccmram")))
#endif
#endif
/**
  * @brief It executes the core of FOC drive that is the controllers for Iqd
  *        currents regulation. Reference frame transformations are carried out
  *        accordingly to the active speed sensor. It must be called periodically
  *        when new motor currents have been converted
  * @param this related object of class CFOC.
  * @retval int16_t It returns MC_NO_FAULTS if the FOC has been ended before
  *         next PWM Update event, MC_DURATION otherwise
  */
inline uint16_t FOC_CurrControllerM1(void)
{
  qd_t Iqd, Vqd;
  ab_t Iab;
  alphabeta_t Ialphabeta, Valphabeta;
  int16_t hElAngle;
  uint16_t hCodeError = MC_NO_FAULTS;
  SpeednPosFdbk_Handle_t *speedHandle;
  speedHandle = STC_GetSpeedSensor(pSTC[M1]);
  hElAngle = SPD_GetElAngle(speedHandle);
  PWMC_GetPhaseCurrents(pwmcHandle[M1], &Iab);
  Ialphabeta = MCM_Clarke(Iab);
  Iqd = MCM_Park(Ialphabeta, hElAngle);
  if (PWMC_GetPWMState(pwmcHandle[M1]) == true)
  {
    Vqd.q = PI_Controller(pPIDIq[M1], (int32_t)(FOCVars[M1].Iqdref.q) - Iqd.q);
    Vqd.d = PI_Controller(pPIDId[M1], (int32_t)(FOCVars[M1].Iqdref.d) - Iqd.d);
  }
  else
  {
    Vqd.q = 0;
    Vqd.d = 0;
  }
#if CAN_DIAG2_FRAME
  /* HAND EDIT outside the USER CODE blocks (CHANGE 7(c), FIRMWARE_CHANGES.txt):
     the Iq PI output before circle limitation, for the DIAG2 frame. */
  s_diagVqReq = Vqd.q;
#endif
  Vqd = Circle_Limitation(&CircleLimitationM1, Vqd);
  Valphabeta = MCM_Rev_Park(Vqd, hElAngle);

  if (PWMC_GetPWMState(pwmcHandle[M1]) == true)
  {
    hCodeError = PWMC_SetPhaseVoltage(pwmcHandle[M1], Valphabeta);
  }
  else
  {
    /* Nothing to do. No PWM setting to prevent possible ChargeBootCap conflict */

  }

  FOCVars[M1].Vqd = Vqd;
  FOCVars[M1].Iab = Iab;
  FOCVars[M1].Ialphabeta = Ialphabeta;
  FOCVars[M1].Iqd = Iqd;
  FOCVars[M1].Valphabeta = Valphabeta;
  FOCVars[M1].hElAngle = hElAngle;

  return (hCodeError);
}

/******************* (C) COPYRIGHT 2026 STMicroelectronics *****END OF FILE****/
