JayChintala/1DOF-FOC-Force-Feedback/ESC_based/STM32/MCWorkbench/Src/main_diff.txt

diff --git a/STM32/MCWorkbench/Src/main.c b/STM32/MCWorkbench/Src/main.c
index 717b7d8..9e156f4 100644
--- a/STM32/MCWorkbench/Src/main.c
+++ b/STM32/MCWorkbench/Src/main.c
@@ -99,18 +99,19 @@ static void MX_NVIC_Init(void);
 /* USER CODE END 0 */
 
 /**
- * @brief  The application entry point.
- * @retval int
- */
-int main(void) {
+  * @brief  The application entry point.
+  * @retval int
+  */
+int main(void)
+{
+
 
   /* MCU Configuration--------------------------------------------------------*/
 
-  /* Reset of all peripherals, Initializes the Flash interface and the Systick.
-   */
+  /* Reset of all peripherals, Initializes the Flash interface and the Systick. */
   HAL_Init();
 
   /* USER CODE BEGIN Init */
@@ -160,20 +161,21 @@ int main(void) {
 }
 
 /**
- * @brief System Clock Configuration
- * @retval None
- */
-void SystemClock_Config(void) {
+  * @brief System Clock Configuration
+  * @retval None
+  */
+void SystemClock_Config(void)
+{
   RCC_OscInitTypeDef RCC_OscInitStruct = {0};
   RCC_ClkInitTypeDef RCC_ClkInitStruct = {0};
 
   /** Configure the main internal regulator output voltage
-   */
+  */
   HAL_PWREx_ControlVoltageScaling(PWR_REGULATOR_VOLTAGE_SCALE1_BOOST);
 
   /** Initializes the RCC Oscillators according to the specified parameters
-   * in the RCC_OscInitTypeDef structure.
-   */
+  * in the RCC_OscInitTypeDef structure.
+  */
   RCC_OscInitStruct.OscillatorType = RCC_OSCILLATORTYPE_HSE;
   RCC_OscInitStruct.HSEState = RCC_HSE_ON;
   RCC_OscInitStruct.PLL.PLLState = RCC_PLL_ON;
@@ -183,33 +185,36 @@ void SystemClock_Config(void) {
   RCC_OscInitStruct.PLL.PLLP = RCC_PLLP_DIV8;
   RCC_OscInitStruct.PLL.PLLQ = RCC_PLLQ_DIV2;
   RCC_OscInitStruct.PLL.PLLR = RCC_PLLR_DIV2;
-  if (HAL_RCC_OscConfig(&RCC_OscInitStruct) != HAL_OK) {
+  if (HAL_RCC_OscConfig(&RCC_OscInitStruct) != HAL_OK)
+  {
     Error_Handler();
   }
 
   /** Initializes the CPU, AHB and APB buses clocks
-   */
-  RCC_ClkInitStruct.ClockType = RCC_CLOCKTYPE_HCLK | RCC_CLOCKTYPE_SYSCLK |
-                                RCC_CLOCKTYPE_PCLK1 | RCC_CLOCKTYPE_PCLK2;
+  */
+  RCC_ClkInitStruct.ClockType = RCC_CLOCKTYPE_HCLK|RCC_CLOCKTYPE_SYSCLK
+                              |RCC_CLOCKTYPE_PCLK1|RCC_CLOCKTYPE_PCLK2;
   RCC_ClkInitStruct.SYSCLKSource = RCC_SYSCLKSOURCE_PLLCLK;
   RCC_ClkInitStruct.AHBCLKDivider = RCC_SYSCLK_DIV1;
   RCC_ClkInitStruct.APB1CLKDivider = RCC_HCLK_DIV1;
   RCC_ClkInitStruct.APB2CLKDivider = RCC_HCLK_DIV1;
 
-  if (HAL_RCC_ClockConfig(&RCC_ClkInitStruct, FLASH_LATENCY_4) != HAL_OK) {
+  if (HAL_RCC_ClockConfig(&RCC_ClkInitStruct, FLASH_LATENCY_4) != HAL_OK)
+  {
     Error_Handler();
   }
 
   /** Enables the Clock Security System
-   */
+  */
   HAL_RCC_EnableCSS();
 }
 
 /**
- * @brief NVIC Configuration.
- * @retval None
- */
-static void MX_NVIC_Init(void) {
+  * @brief NVIC Configuration.
+  * @retval None
+  */
+static void MX_NVIC_Init(void)
+{
   /* USART2_IRQn interrupt configuration */
   HAL_NVIC_SetPriority(USART2_IRQn, 3, 1);
   HAL_NVIC_EnableIRQ(USART2_IRQn);
@@ -234,11 +239,13 @@ static void MX_NVIC_Init(void) {
 }
 
 /**
- * @brief ADC1 Initialization Function
- * @param None
- * @retval None
- */
-static void MX_ADC1_Init(void) {
+  * @brief ADC1 Initialization Function
+  * @param None
+  * @retval None
+  */
+static void MX_ADC1_Init(void)
+{
+
@@ -252,7 +259,7 @@ static void MX_ADC1_Init(void) {
   /* USER CODE END ADC1_Init 1 */
 
   /** Common config
-   */
+  */
   hadc1.Instance = ADC1;
   hadc1.Init.ClockPrescaler = ADC_CLOCK_ASYNC_DIV1;
   hadc1.Init.Resolution = ADC_RESOLUTION_12B;
@@ -269,19 +276,21 @@ static void MX_ADC1_Init(void) {
   hadc1.Init.DMAContinuousRequests = DISABLE;
   hadc1.Init.Overrun = ADC_OVR_DATA_PRESERVED;
   hadc1.Init.OversamplingMode = DISABLE;
-  if (HAL_ADC_Init(&hadc1) != HAL_OK) {
+  if (HAL_ADC_Init(&hadc1) != HAL_OK)
+  {
     Error_Handler();
   }
 
   /** Configure the ADC multi-mode
-   */
+  */
   multimode.Mode = ADC_MODE_INDEPENDENT;
-  if (HAL_ADCEx_MultiModeConfigChannel(&hadc1, &multimode) != HAL_OK) {
+  if (HAL_ADCEx_MultiModeConfigChannel(&hadc1, &multimode) != HAL_OK)
+  {
     Error_Handler();
   }
 
   /** Configure Injected Channel
-   */
+  */
   sConfigInjected.InjectedChannel = ADC_CHANNEL_3;
   sConfigInjected.InjectedRank = ADC_INJECTED_RANK_1;
   sConfigInjected.InjectedSamplingTime = ADC_SAMPLETIME_6CYCLES_5;
@@ -293,51 +302,57 @@ static void MX_ADC1_Init(void) {
   sConfigInjected.AutoInjectedConv = DISABLE;
   sConfigInjected.QueueInjectedContext = DISABLE;
   sConfigInjected.ExternalTrigInjecConv = ADC_EXTERNALTRIGINJEC_T1_CC4;
-  sConfigInjected.ExternalTrigInjecConvEdge =
-      ADC_EXTERNALTRIGINJECCONV_EDGE_RISING;
+  sConfigInjected.ExternalTrigInjecConvEdge = ADC_EXTERNALTRIGINJECCONV_EDGE_RISING;
   sConfigInjected.InjecOversamplingMode = DISABLE;
-  if (HAL_ADCEx_InjectedConfigChannel(&hadc1, &sConfigInjected) != HAL_OK) {
+  if (HAL_ADCEx_InjectedConfigChannel(&hadc1, &sConfigInjected) != HAL_OK)
+  {
     Error_Handler();
   }
 
   /** Configure Injected Channel
-   */
+  */
   sConfigInjected.InjectedChannel = ADC_CHANNEL_12;
   sConfigInjected.InjectedRank = ADC_INJECTED_RANK_2;
-  if (HAL_ADCEx_InjectedConfigChannel(&hadc1, &sConfigInjected) != HAL_OK) {
+  if (HAL_ADCEx_InjectedConfigChannel(&hadc1, &sConfigInjected) != HAL_OK)
+  {
     Error_Handler();
   }
 
   /** Configure Regular Channel
-   */
+  */
   sConfig.Channel = ADC_CHANNEL_1;
   sConfig.Rank = ADC_REGULAR_RANK_1;
   sConfig.SamplingTime = ADC_SAMPLETIME_47CYCLES_5;
   sConfig.SingleDiff = ADC_SINGLE_ENDED;
   sConfig.OffsetNumber = ADC_OFFSET_NONE;
   sConfig.Offset = 0;
-  if (HAL_ADC_ConfigChannel(&hadc1, &sConfig) != HAL_OK) {
+  if (HAL_ADC_ConfigChannel(&hadc1, &sConfig) != HAL_OK)
+  {
     Error_Handler();
   }
 
   /** Configure Regular Channel
-   */
+  */
   sConfig.Channel = ADC_CHANNEL_5;
   sConfig.Rank = ADC_REGULAR_RANK_2;
-  if (HAL_ADC_ConfigChannel(&hadc1, &sConfig) != HAL_OK) {
+  if (HAL_ADC_ConfigChannel(&hadc1, &sConfig) != HAL_OK)
+  {
     Error_Handler();
   }
+
 }
 
 /**
- * @brief ADC2 Initialization Function
- * @param None
- * @retval None
- */
-static void MX_ADC2_Init(void) {
+  * @brief ADC2 Initialization Function
+  * @param None
+  * @retval None
+  */
+static void MX_ADC2_Init(void)
+{
+
@@ -349,7 +364,7 @@ static void MX_ADC2_Init(void) {
   /* USER CODE END ADC2_Init 1 */
 
   /** Common config
-   */
+  */
   hadc2.Instance = ADC2;
   hadc2.Init.ClockPrescaler = ADC_CLOCK_ASYNC_DIV1;
   hadc2.Init.Resolution = ADC_RESOLUTION_12B;
@@ -364,12 +379,13 @@ static void MX_ADC2_Init(void) {
   hadc2.Init.DMAContinuousRequests = DISABLE;
   hadc2.Init.Overrun = ADC_OVR_DATA_PRESERVED;
   hadc2.Init.OversamplingMode = DISABLE;
-  if (HAL_ADC_Init(&hadc2) != HAL_OK) {
+  if (HAL_ADC_Init(&hadc2) != HAL_OK)
+  {
     Error_Handler();
   }
 
   /** Configure Injected Channel
-   */
+  */
   sConfigInjected.InjectedChannel = ADC_CHANNEL_VOPAMP3_ADC2;
   sConfigInjected.InjectedRank = ADC_INJECTED_RANK_1;
   sConfigInjected.InjectedSamplingTime = ADC_SAMPLETIME_6CYCLES_5;
@@ -381,31 +397,35 @@ static void MX_ADC2_Init(void) {
   sConfigInjected.AutoInjectedConv = DISABLE;
   sConfigInjected.QueueInjectedContext = DISABLE;
   sConfigInjected.ExternalTrigInjecConv = ADC_EXTERNALTRIGINJEC_T1_CC4;
-  sConfigInjected.ExternalTrigInjecConvEdge =
-      ADC_EXTERNALTRIGINJECCONV_EDGE_RISING;
+  sConfigInjected.ExternalTrigInjecConvEdge = ADC_EXTERNALTRIGINJECCONV_EDGE_RISING;
   sConfigInjected.InjecOversamplingMode = DISABLE;
-  if (HAL_ADCEx_InjectedConfigChannel(&hadc2, &sConfigInjected) != HAL_OK) {
+  if (HAL_ADCEx_InjectedConfigChannel(&hadc2, &sConfigInjected) != HAL_OK)
+  {
     Error_Handler();
   }
 
   /** Configure Injected Channel
-   */
+  */
   sConfigInjected.InjectedChannel = ADC_CHANNEL_3;
   sConfigInjected.InjectedRank = ADC_INJECTED_RANK_2;
-  if (HAL_ADCEx_InjectedConfigChannel(&hadc2, &sConfigInjected) != HAL_OK) {
+  if (HAL_ADCEx_InjectedConfigChannel(&hadc2, &sConfigInjected) != HAL_OK)
+  {
     Error_Handler();
   }
+
 }
 
 /**
- * @brief COMP1 Initialization Function
- * @param None
- * @retval None
- */
-static void MX_COMP1_Init(void) {
+  * @brief COMP1 Initialization Function
+  * @param None
+  * @retval None
+  */
+static void MX_COMP1_Init(void)
+{
+
@@ -420,20 +440,24 @@ static void MX_COMP1_Init(void) {
   hcomp1.Init.Hysteresis = COMP_HYSTERESIS_NONE;
   hcomp1.Init.BlankingSrce = COMP_BLANKINGSRC_NONE;
   hcomp1.Init.TriggerMode = COMP_TRIGGERMODE_NONE;
-  if (HAL_COMP_Init(&hcomp1) != HAL_OK) {
+  if (HAL_COMP_Init(&hcomp1) != HAL_OK)
+  {
     Error_Handler();
   }
+
 }
 
 /**
- * @brief COMP2 Initialization Function
- * @param None
- * @retval None
- */
-static void MX_COMP2_Init(void) {
+  * @brief COMP2 Initialization Function
+  * @param None
+  * @retval None
+  */
+static void MX_COMP2_Init(void)
+{
+
@@ -448,20 +472,24 @@ static void MX_COMP2_Init(void) {
   hcomp2.Init.Hysteresis = COMP_HYSTERESIS_NONE;
   hcomp2.Init.BlankingSrce = COMP_BLANKINGSRC_NONE;
   hcomp2.Init.TriggerMode = COMP_TRIGGERMODE_NONE;
-  if (HAL_COMP_Init(&hcomp2) != HAL_OK) {
+  if (HAL_COMP_Init(&hcomp2) != HAL_OK)
+  {
     Error_Handler();
   }
+
 }
 
 /**
- * @brief COMP4 Initialization Function
- * @param None
- * @retval None
- */
-static void MX_COMP4_Init(void) {
+  * @brief COMP4 Initialization Function
+  * @param None
+  * @retval None
+  */
+static void MX_COMP4_Init(void)
+{
+
@@ -476,20 +504,24 @@ static void MX_COMP4_Init(void) {
   hcomp4.Init.Hysteresis = COMP_HYSTERESIS_NONE;
   hcomp4.Init.BlankingSrce = COMP_BLANKINGSRC_NONE;
   hcomp4.Init.TriggerMode = COMP_TRIGGERMODE_NONE;
-  if (HAL_COMP_Init(&hcomp4) != HAL_OK) {
+  if (HAL_COMP_Init(&hcomp4) != HAL_OK)
+  {
     Error_Handler();
   }
+
 }
 
 /**
- * @brief CORDIC Initialization Function
- * @param None
- * @retval None
- */
-static void MX_CORDIC_Init(void) {
+  * @brief CORDIC Initialization Function
+  * @param None
+  * @retval None
+  */
+static void MX_CORDIC_Init(void)
+{
+
@@ -498,20 +530,24 @@ static void MX_CORDIC_Init(void) {
 
   /* USER CODE END CORDIC_Init 1 */
   hcordic.Instance = CORDIC;
-  if (HAL_CORDIC_Init(&hcordic) != HAL_OK) {
+  if (HAL_CORDIC_Init(&hcordic) != HAL_OK)
+  {
     Error_Handler();
   }
+
 }
 
 /**
- * @brief DAC3 Initialization Function
- * @param None
- * @retval None
- */
-static void MX_DAC3_Init(void) {
+  * @brief DAC3 Initialization Function
+  * @param None
+  * @retval None
+  */
+static void MX_DAC3_Init(void)
+{
+
@@ -523,14 +559,15 @@ static void MX_DAC3_Init(void) {
   /* USER CODE END DAC3_Init 1 */
 
   /** DAC Initialization
-   */
+  */
   hdac3.Instance = DAC3;
-  if (HAL_DAC_Init(&hdac3) != HAL_OK) {
+  if (HAL_DAC_Init(&hdac3) != HAL_OK)
+  {
     Error_Handler();
   }
 
   /** DAC channel OUT1 config
-   */
+  */
   sConfig.DAC_HighFrequency = DAC_HIGH_FREQUENCY_INTERFACE_MODE_AUTOMATIC;
   sConfig.DAC_DMADoubleDataMode = DISABLE;
   sConfig.DAC_SignedFormat = DISABLE;
@@ -540,26 +577,31 @@ static void MX_DAC3_Init(void) {
   sConfig.DAC_OutputBuffer = DAC_OUTPUTBUFFER_DISABLE;
   sConfig.DAC_ConnectOnChipPeripheral = DAC_CHIPCONNECT_INTERNAL;
   sConfig.DAC_UserTrimming = DAC_TRIMMING_FACTORY;
-  if (HAL_DAC_ConfigChannel(&hdac3, &sConfig, DAC_CHANNEL_1) != HAL_OK) {
+  if (HAL_DAC_ConfigChannel(&hdac3, &sConfig, DAC_CHANNEL_1) != HAL_OK)
+  {
     Error_Handler();
   }
 
   /** DAC channel OUT2 config
-   */
-  if (HAL_DAC_ConfigChannel(&hdac3, &sConfig, DAC_CHANNEL_2) != HAL_OK) {
+  */
+  if (HAL_DAC_ConfigChannel(&hdac3, &sConfig, DAC_CHANNEL_2) != HAL_OK)
+  {
     Error_Handler();
   }
+
 }
 
 /**
- * @brief FDCAN1 Initialization Function
- * @param None
- * @retval None
- */
-static void MX_FDCAN1_Init(void) {
+  * @brief FDCAN1 Initialization Function
+  * @param None
+  * @retval None
+  */
+static void MX_FDCAN1_Init(void)
+{
+
@@ -585,20 +627,24 @@ static void MX_FDCAN1_Init(void) {
   hfdcan1.Init.StdFiltersNbr = 1;
   hfdcan1.Init.ExtFiltersNbr = 0;
   hfdcan1.Init.TxFifoQueueMode = FDCAN_TX_FIFO_OPERATION;
-  if (HAL_FDCAN_Init(&hfdcan1) != HAL_OK) {
+  if (HAL_FDCAN_Init(&hfdcan1) != HAL_OK)
+  {
     Error_Handler();
   }
+
 }
 
 /**
- * @brief OPAMP1 Initialization Function
- * @param None
- * @retval None
- */
-static void MX_OPAMP1_Init(void) {
+  * @brief OPAMP1 Initialization Function
+  * @param None
+  * @retval None
+  */
+static void MX_OPAMP1_Init(void)
+{
+
@@ -615,20 +661,24 @@ static void MX_OPAMP1_Init(void) {
   hopamp1.Init.PgaConnect = OPAMP_PGA_CONNECT_INVERTINGINPUT_IO0_BIAS;
   hopamp1.Init.PgaGain = OPAMP_PGA_GAIN_8_OR_MINUS_7;
   hopamp1.Init.UserTrimming = OPAMP_TRIMMING_FACTORY;
-  if (HAL_OPAMP_Init(&hopamp1) != HAL_OK) {
+  if (HAL_OPAMP_Init(&hopamp1) != HAL_OK)
+  {
     Error_Handler();
   }
+
 }
 
 /**
- * @brief OPAMP2 Initialization Function
- * @param None
- * @retval None
- */
-static void MX_OPAMP2_Init(void) {
+  * @brief OPAMP2 Initialization Function
+  * @param None
+  * @retval None
+  */
+static void MX_OPAMP2_Init(void)
+{
+
@@ -645,20 +695,24 @@ static void MX_OPAMP2_Init(void) {
   hopamp2.Init.PgaConnect = OPAMP_PGA_CONNECT_INVERTINGINPUT_IO0_BIAS;
   hopamp2.Init.PgaGain = OPAMP_PGA_GAIN_8_OR_MINUS_7;
   hopamp2.Init.UserTrimming = OPAMP_TRIMMING_FACTORY;
-  if (HAL_OPAMP_Init(&hopamp2) != HAL_OK) {
+  if (HAL_OPAMP_Init(&hopamp2) != HAL_OK)
+  {
     Error_Handler();
   }
+
 }
 
 /**
- * @brief OPAMP3 Initialization Function
- * @param None
- * @retval None
- */
-static void MX_OPAMP3_Init(void) {
+  * @brief OPAMP3 Initialization Function
+  * @param None
+  * @retval None
+  */
+static void MX_OPAMP3_Init(void)
+{
+
@@ -675,20 +729,24 @@ static void MX_OPAMP3_Init(void) {
   hopamp3.Init.PgaConnect = OPAMP_PGA_CONNECT_INVERTINGINPUT_IO0_BIAS;
   hopamp3.Init.PgaGain = OPAMP_PGA_GAIN_8_OR_MINUS_7;
   hopamp3.Init.UserTrimming = OPAMP_TRIMMING_FACTORY;
-  if (HAL_OPAMP_Init(&hopamp3) != HAL_OK) {
+  if (HAL_OPAMP_Init(&hopamp3) != HAL_OK)
+  {
     Error_Handler();
   }
+
 }
 
 /**
- * @brief TIM1 Initialization Function
- * @param None
- * @retval None
- */
-static void MX_TIM1_Init(void) {
+  * @brief TIM1 Initialization Function
+  * @param None
+  * @retval None
+  */
+static void MX_TIM1_Init(void)
+{
+
@@ -702,36 +760,38 @@ static void MX_TIM1_Init(void) {
 
   /* USER CODE END TIM1_Init 1 */
   htim1.Instance = TIM1;
-  htim1.Init.Prescaler = ((TIM_CLOCK_DIVIDER)-1);
+  htim1.Init.Prescaler = ((TIM_CLOCK_DIVIDER) - 1);
   htim1.Init.CounterMode = TIM_COUNTERMODE_CENTERALIGNED1;
   htim1.Init.Period = ((PWM_PERIOD_CYCLES) / 2);
   htim1.Init.ClockDivision = TIM_CLOCKDIVISION_DIV2;
   htim1.Init.RepetitionCounter = (REP_COUNTER);
   htim1.Init.AutoReloadPreload = TIM_AUTORELOAD_PRELOAD_DISABLE;
-  if (HAL_TIM_PWM_Init(&htim1) != HAL_OK) {
+  if (HAL_TIM_PWM_Init(&htim1) != HAL_OK)
+  {
     Error_Handler();
   }
   sMasterConfig.MasterOutputTrigger = TIM_TRGO_OC4REF;
   sMasterConfig.MasterOutputTrigger2 = TIM_TRGO2_RESET;
   sMasterConfig.MasterSlaveMode = TIM_MASTERSLAVEMODE_DISABLE;
-  if (HAL_TIMEx_MasterConfigSynchronization(&htim1, &sMasterConfig) != HAL_OK) {
+  if (HAL_TIMEx_MasterConfigSynchronization(&htim1, &sMasterConfig) != HAL_OK)
+  {
     Error_Handler();
   }
   sBreakInputConfig.Source = TIM_BREAKINPUTSOURCE_COMP1;
   sBreakInputConfig.Enable = TIM_BREAKINPUTSOURCE_ENABLE;
   sBreakInputConfig.Polarity = TIM_BREAKINPUTSOURCE_POLARITY_HIGH;
-  if (HAL_TIMEx_ConfigBreakInput(&htim1, TIM_BREAKINPUT_BRK,
-                                 &sBreakInputConfig) != HAL_OK) {
+  if (HAL_TIMEx_ConfigBreakInput(&htim1, TIM_BREAKINPUT_BRK, &sBreakInputConfig) != HAL_OK)
+  {
     Error_Handler();
   }
   sBreakInputConfig.Source = TIM_BREAKINPUTSOURCE_COMP2;
-  if (HAL_TIMEx_ConfigBreakInput(&htim1, TIM_BREAKINPUT_BRK,
-                                 &sBreakInputConfig) != HAL_OK) {
+  if (HAL_TIMEx_ConfigBreakInput(&htim1, TIM_BREAKINPUT_BRK, &sBreakInputConfig) != HAL_OK)
+  {
     Error_Handler();
   }
   sBreakInputConfig.Source = TIM_BREAKINPUTSOURCE_COMP4;
-  if (HAL_TIMEx_ConfigBreakInput(&htim1, TIM_BREAKINPUT_BRK,
-                                 &sBreakInputConfig) != HAL_OK) {
+  if (HAL_TIMEx_ConfigBreakInput(&htim1, TIM_BREAKINPUT_BRK, &sBreakInputConfig) != HAL_OK)
+  {
     Error_Handler();
   }
   sConfigOC.OCMode = TIM_OCMODE_PWM1;
@@ -741,19 +801,23 @@ static void MX_TIM1_Init(void) {
   sConfigOC.OCFastMode = TIM_OCFAST_DISABLE;
   sConfigOC.OCIdleState = TIM_OCIDLESTATE_RESET;
   sConfigOC.OCNIdleState = TIM_OCNIDLESTATE_RESET;
-  if (HAL_TIM_PWM_ConfigChannel(&htim1, &sConfigOC, TIM_CHANNEL_1) != HAL_OK) {
+  if (HAL_TIM_PWM_ConfigChannel(&htim1, &sConfigOC, TIM_CHANNEL_1) != HAL_OK)
+  {
     Error_Handler();
   }
   sConfigOC.Pulse = ((PWM_PERIOD_CYCLES) / 4);
-  if (HAL_TIM_PWM_ConfigChannel(&htim1, &sConfigOC, TIM_CHANNEL_2) != HAL_OK) {
+  if (HAL_TIM_PWM_ConfigChannel(&htim1, &sConfigOC, TIM_CHANNEL_2) != HAL_OK)
+  {
     Error_Handler();
   }
-  if (HAL_TIM_PWM_ConfigChannel(&htim1, &sConfigOC, TIM_CHANNEL_3) != HAL_OK) {
+  if (HAL_TIM_PWM_ConfigChannel(&htim1, &sConfigOC, TIM_CHANNEL_3) != HAL_OK)
+  {
     Error_Handler();
   }
   sConfigOC.OCMode = TIM_OCMODE_PWM2;
   sConfigOC.Pulse = (((PWM_PERIOD_CYCLES) / 2) - (HTMIN));
-  if (HAL_TIM_PWM_ConfigChannel(&htim1, &sConfigOC, TIM_CHANNEL_4) != HAL_OK) {
+  if (HAL_TIM_PWM_ConfigChannel(&htim1, &sConfigOC, TIM_CHANNEL_4) != HAL_OK)
+  {
     Error_Handler();
   }
   sBreakDeadTimeConfig.OffStateRunMode = TIM_OSSR_ENABLE;
@@ -769,21 +833,25 @@ static void MX_TIM1_Init(void) {
   sBreakDeadTimeConfig.Break2Filter = 3;
   sBreakDeadTimeConfig.Break2AFMode = TIM_BREAK_AFMODE_INPUT;
   sBreakDeadTimeConfig.AutomaticOutput = TIM_AUTOMATICOUTPUT_DISABLE;
-  if (HAL_TIMEx_ConfigBreakDeadTime(&htim1, &sBreakDeadTimeConfig) != HAL_OK) {
+  if (HAL_TIMEx_ConfigBreakDeadTime(&htim1, &sBreakDeadTimeConfig) != HAL_OK)
+  {
     Error_Handler();
   }
   HAL_TIM_MspPostInit(&htim1);
+
 }
 
 /**
- * @brief TIM4 Initialization Function
- * @param None
- * @retval None
- */
-static void MX_TIM4_Init(void) {
+  * @brief TIM4 Initialization Function
+  * @param None
+  * @retval None
+  */
+static void MX_TIM4_Init(void)
+{
+
@@ -809,25 +877,30 @@ static void MX_TIM4_Init(void) {
   sConfig.IC2Selection = TIM_ICSELECTION_DIRECTTI;
   sConfig.IC2Prescaler = TIM_ICPSC_DIV1;
   sConfig.IC2Filter = M1_ENC_IC_FILTER;
-  if (HAL_TIM_Encoder_Init(&htim4, &sConfig) != HAL_OK) {
+  if (HAL_TIM_Encoder_Init(&htim4, &sConfig) != HAL_OK)
+  {
     Error_Handler();
   }
   sMasterConfig.MasterOutputTrigger = TIM_TRGO_RESET;
   sMasterConfig.MasterSlaveMode = TIM_MASTERSLAVEMODE_DISABLE;
-  if (HAL_TIMEx_MasterConfigSynchronization(&htim4, &sMasterConfig) != HAL_OK) {
+  if (HAL_TIMEx_MasterConfigSynchronization(&htim4, &sMasterConfig) != HAL_OK)
+  {
     Error_Handler();
   }
+
 }
 
 /**
- * @brief USART2 Initialization Function
- * @param None
- * @retval None
- */
-static void MX_USART2_UART_Init(void) {
+  * @brief USART2 Initialization Function
+  * @param None
+  * @retval None
+  */
+static void MX_USART2_UART_Init(void)
+{
+
@@ -846,40 +919,47 @@ static void MX_USART2_UART_Init(void) {
   huart2.Init.OneBitSampling = UART_ONE_BIT_SAMPLE_DISABLE;
   huart2.Init.ClockPrescaler = UART_PRESCALER_DIV1;
   huart2.AdvancedInit.AdvFeatureInit = UART_ADVFEATURE_NO_INIT;
-  if (HAL_UART_Init(&huart2) != HAL_OK) {
+  if (HAL_UART_Init(&huart2) != HAL_OK)
+  {
     Error_Handler();
   }
-  if (HAL_UARTEx_SetTxFifoThreshold(&huart2, UART_TXFIFO_THRESHOLD_1_8) !=
-      HAL_OK) {
+  if (HAL_UARTEx_SetTxFifoThreshold(&huart2, UART_TXFIFO_THRESHOLD_1_8) != HAL_OK)
+  {
     Error_Handler();
   }
-  if (HAL_UARTEx_SetRxFifoThreshold(&huart2, UART_RXFIFO_THRESHOLD_1_8) !=
-      HAL_OK) {
+  if (HAL_UARTEx_SetRxFifoThreshold(&huart2, UART_RXFIFO_THRESHOLD_1_8) != HAL_OK)
+  {
     Error_Handler();
   }
-  if (HAL_UARTEx_DisableFifoMode(&huart2) != HAL_OK) {
+  if (HAL_UARTEx_DisableFifoMode(&huart2) != HAL_OK)
+  {
     Error_Handler();
   }
+
 }
 
 /**
- * Enable DMA controller clock
- */
-static void MX_DMA_Init(void) {
+  * Enable DMA controller clock
+  */
+static void MX_DMA_Init(void)
+{
+
   /* DMA controller clock enable */
   __HAL_RCC_DMAMUX1_CLK_ENABLE();
   __HAL_RCC_DMA1_CLK_ENABLE();
+
 }
 
 /**
- * @brief GPIO Initialization Function
- * @param None
- * @retval None
- */
-static void MX_GPIO_Init(void) {
+  * @brief GPIO Initialization Function
+  * @param None
+  * @retval None
+  */
+static void MX_GPIO_Init(void)
+{
   GPIO_InitTypeDef GPIO_InitStruct = {0};
   /* USER CODE BEGIN MX_GPIO_Init_1 */
 
@@ -892,14 +972,16 @@ static void MX_GPIO_Init(void) {
   __HAL_RCC_GPIOB_CLK_ENABLE();
 
   /*Configure GPIO pin Output Level */
-  HAL_GPIO_WritePin(GPIOC, CAN_SHDN_Pin, GPIO_PIN_RESET);   /* LOW = normal mode */
-  HAL_GPIO_WritePin(GPIOC, CAN_TERM_Pin, GPIO_PIN_SET);      /* keep as-is if you want termination ON ΓÇö confirm against Table 3 in UM2516 */
+  HAL_GPIO_WritePin(CAN_TERM_GPIO_Port, CAN_TERM_Pin, GPIO_PIN_SET);
 
   /*Configure GPIO pin Output Level */
   HAL_GPIO_WritePin(CAN_TERM_ALT_GPIO_Port, CAN_TERM_ALT_Pin, GPIO_PIN_SET);
 
+  /*Configure GPIO pin Output Level */
+  HAL_GPIO_WritePin(CAN_SHDN_GPIO_Port, CAN_SHDN_Pin, GPIO_PIN_RESET);
+
   /*Configure GPIO pins : CAN_TERM_Pin CAN_SHDN_Pin */
-  GPIO_InitStruct.Pin = CAN_TERM_Pin | CAN_SHDN_Pin;
+  GPIO_InitStruct.Pin = CAN_TERM_Pin|CAN_SHDN_Pin;
   GPIO_InitStruct.Mode = GPIO_MODE_OUTPUT_PP;
   GPIO_InitStruct.Pull = GPIO_NOPULL;
   GPIO_InitStruct.Speed = GPIO_SPEED_FREQ_LOW;
@@ -928,10 +1010,11 @@ static void MX_GPIO_Init(void) {
 /* USER CODE END 4 */
 
 /**
- * @brief  This function is executed in case of error occurrence.
- * @retval None
- */
-void Error_Handler(void) {
+  * @brief  This function is executed in case of error occurrence.
+  * @retval None
+  */
+void Error_Handler(void)
+{
   /* USER CODE BEGIN Error_Handler_Debug */
   /* User can add his own implementation to report the HAL error return state */
   __disable_irq();
@@ -941,13 +1024,14 @@ void Error_Handler(void) {
 }
 #ifdef USE_FULL_ASSERT
 /**
- * @brief  Reports the name of the source file and the source line number
- *         where the assert_param error has occurred.
- * @param  file: pointer to the source file name
- * @param  line: assert_param error line source number
- * @retval None
- */
-void assert_failed(uint8_t* file, uint32_t line) {
+  * @brief  Reports the name of the source file and the source line number
+  *         where the assert_param error has occurred.
+  * @param  file: pointer to the source file name
+  * @param  line: assert_param error line source number
+  * @retval None
+  */
+void assert_failed(uint8_t *file, uint32_t line)
+{
   /* USER CODE BEGIN 6 */
   /* User can add his own implementation to report the file name and line
      number, ex: printf("Wrong parameters value: file %s on line %d\r\n", file,
