JayChintala/1DOF-FOC-Force-Feedback/ESC_based/STM32/MCWorkbench/Inc/main.h

#define CAN_TERM_Pin GPIO_PIN_14
#define CAN_TERM_GPIO_Port GPIOC
#define M1_BUS_VOLTAGE_Pin GPIO_PIN_0
#define M1_BUS_VOLTAGE_GPIO_Port GPIOA
#define M1_CURR_SHUNT_U_Pin GPIO_PIN_1
#define M1_CURR_SHUNT_U_GPIO_Port GPIOA
#define M1_OPAMP1_OUT_Pin GPIO_PIN_2
#define M1_OPAMP1_OUT_GPIO_Port GPIOA
#define M1_OPAMP1_INT_GAIN_Pin GPIO_PIN_3
#define M1_OPAMP1_INT_GAIN_GPIO_Port GPIOA
#define M1_OPAMP2_INT_GAIN_Pin GPIO_PIN_5
#define M1_OPAMP2_INT_GAIN_GPIO_Port GPIOA
#define M1_OPAMP2_OUT_Pin GPIO_PIN_6
#define M1_OPAMP2_OUT_GPIO_Port GPIOA
#define M1_CURR_SHUNT_V_Pin GPIO_PIN_7
#define M1_CURR_SHUNT_V_GPIO_Port GPIOA
#define M1_CURR_SHUNT_W_Pin GPIO_PIN_0
#define M1_CURR_SHUNT_W_GPIO_Port GPIOB
#define M1_OPAMP3_OUT_Pin GPIO_PIN_1
#define M1_OPAMP3_OUT_GPIO_Port GPIOB
#define M1_OPAMP3_INT_GAIN_Pin GPIO_PIN_2
#define M1_OPAMP3_INT_GAIN_GPIO_Port GPIOB
#define CAN_TERM_ALT_Pin GPIO_PIN_13
#define CAN_TERM_ALT_GPIO_Port GPIOB
#define M1_TEMPERATURE_Pin GPIO_PIN_14
#define M1_TEMPERATURE_GPIO_Port GPIOB
#define M1_PWM_WL_Pin GPIO_PIN_15
#define M1_PWM_WL_GPIO_Port GPIOB
#define M1_PWM_UH_Pin GPIO_PIN_8
#define M1_PWM_UH_GPIO_Port GPIOA
#define M1_PWM_VH_Pin GPIO_PIN_9
#define M1_PWM_VH_GPIO_Port GPIOA
#define M1_PWM_WH_Pin GPIO_PIN_10
#define M1_PWM_WH_GPIO_Port GPIOA
#define M1_PWM_VL_Pin GPIO_PIN_12
#define M1_PWM_VL_GPIO_Port GPIOA
#define Start_Stop_Pin GPIO_PIN_10
#define Start_Stop_GPIO_Port GPIOC
#define Start_Stop_EXTI_IRQn EXTI15_10_IRQn
#define CAN_SHDN_Pin GPIO_PIN_11
#define CAN_SHDN_GPIO_Port GPIOC
#define UART_TX_Pin GPIO_PIN_3
#define UART_TX_GPIO_Port GPIOB
#define UART_RX_Pin GPIO_PIN_4
#define UART_RX_GPIO_Port GPIOB
#define M1_ENCODER_A_Pin GPIO_PIN_6
#define M1_ENCODER_A_GPIO_Port GPIOB
#define M1_ENCODER_B_Pin GPIO_PIN_7
#define M1_ENCODER_B_GPIO_Port GPIOB
