JayChintala/1DOF-FOC-Force-Feedback/ESC_based/STM32/MCWorkbench/Src/sync_registers.c

/**
  ******************************************************************************
  * @file    sync_registers.c
  * @author  Motor Control SDK Team, ST Microelectronics
  * @brief   This file provides firmware functions that implement the register
  * access for the synchronous part of the MCP protocol.
  *
  *
  ******************************************************************************
  * @attention
  *
  * <h2><center>&copy; Copyright (c) 2026 STMicroelectronics.
  * All rights reserved.</center></h2>
  *
  * This software component is licensed by ST under Ultimate Liberty license
  * SLA0044, the "License"; You may not use this file except in compliance with
  * the License. You may obtain a copy of the License at:
  *                             www.st.com/SLA0044
  *
  ******************************************************************************
  */

#include "mc_type.h"
#include "string.h"
#include "register_interface.h"
#include "mc_config.h"
#include "mcp.h"
#include "mcp_config.h"
#include "mcpa.h"
#include "mc_configuration_registers.h"

uint8_t RI_SetRegisterGlobal(uint16_t regID, uint8_t typeID, uint8_t *data, uint16_t *size, int16_t dataAvailable)
{
  uint8_t retVal = MCP_CMD_OK;
  switch(typeID)
  {
    case TYPE_DATA_8BIT:
    {
      switch (regID)
      {
        case MC_REG_STATUS:
        {
          retVal = MCP_ERROR_RO_REG;
          break;
        }

        default:
        {
          retVal = MCP_ERROR_UNKNOWN_REG;
          break;
        }
      }
      *size = 1;
      break;
    }

    case TYPE_DATA_16BIT:
    {
      switch (regID)
      {

        case MC_REG_BUS_VOLTAGE:
        case MC_REG_HEATS_TEMP:
        case MC_REG_MOTOR_POWER:
        {
          retVal = MCP_ERROR_RO_REG;
          break;
        }

        case MC_REG_DAC_USER1:
        case MC_REG_DAC_USER2:
        break;

        default:
        {
          retVal = MCP_ERROR_UNKNOWN_REG;
          break;
        }
      }
      *size = 2;
      break;
    }

    case TYPE_DATA_32BIT:
    {

      switch (regID)
      {
        case MC_REG_FAULTS_FLAGS:
        {
          retVal = MCP_ERROR_RO_REG;
          break;
        }

        default:
        {
          retVal = MCP_ERROR_UNKNOWN_REG;
          break;
        }
      }
      *size = 4;
      break;
    }

    case TYPE_DATA_STRING:
    {
      const char_t *charData = (const char_t *)data;
      char_t *dummy = (char_t *)data;
      retVal = MCP_ERROR_RO_REG;
      /* Used to compute String length stored in RXBUFF even if Reg does not exist */
      /* It allows to jump to the next command in the buffer */
      (void)RI_MovString(charData, dummy, size, dataAvailable);
      break;
    }

    case TYPE_DATA_RAW:
    {
      uint16_t rawSize = *(uint16_t *)data; //cstat !MISRAC2012-Rule-11.3
      /* The size consumed by the structure is the structure size + 2 bytes used to store the size */
      *size = rawSize + 2U;
      uint8_t *rawData = data; /* rawData points to the first data (after size extraction) */
      rawData++;
      rawData++;

      if (*size > (uint16_t)dataAvailable)
      {
        /* The decoded size of the raw structure can not match with transmitted buffer, error in buffer
           construction */
        *size = 0;
        retVal = MCP_ERROR_BAD_RAW_FORMAT; /* This error stop the parsing of the CMD buffer */
      }
      else
      {
        switch (regID)
        {
          case MC_REG_APPLICATION_CONFIG:
          case MC_REG_MOTOR_CONFIG:
          case MC_REG_GLOBAL_CONFIG:
          case MC_REG_FOCFW_CONFIG:
          {
            retVal = MCP_ERROR_RO_REG;
            break;
          }

          default:
          {
            retVal = MCP_ERROR_UNKNOWN_REG;
            break;
          }
        }

      }
      break;
    }

    default:
    {
      retVal = MCP_ERROR_BAD_DATA_TYPE;
      *size =0; /* From this point we are not able anymore to decode the RX buffer */
      break;
    }
  }
  return (retVal);
}

uint8_t RI_SetRegisterMotor1(uint16_t regID, uint8_t typeID, uint8_t *data, uint16_t *size, int16_t dataAvailable)
{
  uint8_t retVal = MCP_CMD_OK;
  uint8_t motorID=0;
  MCI_Handle_t *pMCIN = &Mci[motorID];

  switch(typeID)
  {
    case TYPE_DATA_8BIT:
    {
      switch (regID)
      {
        case MC_REG_STATUS:
          {
            retVal = MCP_ERROR_RO_REG;
            break;
          }
        case MC_REG_SECTOR:
          {
            retVal = MCP_ERROR_RO_REG;
            break;
          }
        case MC_REG_CONTROL_MODE:
        {
          uint8_t regdata8 = *data;

          if ((uint8_t)MCM_TORQUE_MODE == regdata8)
          {

            MCI_ExecTorqueRamp(pMCIN, MCI_GetTeref(pMCIN), 0);
          }
          else
          {
            /* Nothing to do */
          }

          if ((uint8_t)MCM_SPEED_MODE == regdata8)
          {
            MCI_ExecSpeedRamp(pMCIN, MCI_GetMecSpeedRefUnit(pMCIN), 0);
          }
          else
          {
            /* Nothing to do */
          }
          break;
        }

        default:
        {
          retVal = MCP_ERROR_UNKNOWN_REG;
          break;
        }
      }
      *size = 1;
      break;
    }

    case TYPE_DATA_16BIT:
    {
      uint16_t regdata16 = *(uint16_t *)data; //cstat !MISRAC2012-Rule-11.3
      switch (regID)
      {

        case MC_REG_SPEED_KP:
        {
          PID_SetKP(&PIDSpeedHandle_M1, (int16_t)regdata16);
          break;
        }

        case MC_REG_SPEED_KI:
        {
          PID_SetKI(&PIDSpeedHandle_M1, (int16_t)regdata16);
          break;
        }

        case MC_REG_SPEED_KD:
        {
          PID_SetKD(&PIDSpeedHandle_M1, (int16_t)regdata16);
          break;
        }

        case MC_REG_I_Q_KP:
        {
          PID_SetKP(&PIDIqHandle_M1, (int16_t)regdata16);
          break;
        }

        case MC_REG_I_Q_KI:
        {
          PID_SetKI(&PIDIqHandle_M1, (int16_t)regdata16);
          break;
        }

        case MC_REG_I_Q_KD:
        {
          PID_SetKD(&PIDIqHandle_M1, (int16_t)regdata16);
          break;
        }

        case MC_REG_I_D_KP:
        {
          PID_SetKP(&PIDIdHandle_M1, (int16_t)regdata16);
          break;
        }

        case MC_REG_I_D_KI:
        {
          PID_SetKI(&PIDIdHandle_M1, (int16_t)regdata16);
          break;
        }

        case MC_REG_I_D_KD:
        {
          PID_SetKD(&PIDIdHandle_M1, (int16_t)regdata16);
          break;
        }

        case MC_REG_BUS_VOLTAGE:
        case MC_REG_HEATS_TEMP:
        case MC_REG_MOTOR_POWER:
        {
          retVal = MCP_ERROR_RO_REG;
          break;
        }

        case MC_REG_I_A:
        case MC_REG_I_B:
        case MC_REG_I_ALPHA_MEAS:
        case MC_REG_I_BETA_MEAS:
        case MC_REG_I_Q_MEAS:
        case MC_REG_I_D_MEAS:
        case MC_REG_FLUXWK_BUS_MEAS:
        {
          retVal = MCP_ERROR_RO_REG;
          break;
        }

        case MC_REG_I_Q_REF:
        {
          qd_t currComp;
          currComp = MCI_GetIqdref(pMCIN);
          currComp.q = (int16_t)regdata16;
          MCI_SetCurrentReferences(pMCIN,currComp);
          break;
        }

        case MC_REG_I_D_REF:
        {
          qd_t currComp;
          currComp = MCI_GetIqdref(pMCIN);
          currComp.d = (int16_t)regdata16;
          MCI_SetCurrentReferences(pMCIN,currComp);
          break;
        }

        case MC_REG_V_Q:
        case MC_REG_V_D:
        case MC_REG_V_ALPHA:
        case MC_REG_V_BETA:
        case MC_REG_ENCODER_EL_ANGLE:
        case MC_REG_ENCODER_SPEED:
        {
          retVal = MCP_ERROR_RO_REG;
          break;
        }

        case MC_REG_DAC_USER1:
        case MC_REG_DAC_USER2:
          break;

        case MC_REG_SPEED_KP_DIV:
        {
          PID_SetKPDivisorPOW2(&PIDSpeedHandle_M1, regdata16);
          break;
        }

        case MC_REG_SPEED_KI_DIV:
        {
          PID_SetKIDivisorPOW2(&PIDSpeedHandle_M1, regdata16);
          break;
        }

        case MC_REG_SPEED_KD_DIV:
        {
          PID_SetKDDivisorPOW2(&PIDSpeedHandle_M1, regdata16);
          break;
        }

        case MC_REG_I_D_KP_DIV:
        {
          PID_SetKPDivisorPOW2(&PIDIdHandle_M1, regdata16);
          break;
        }

        case MC_REG_I_D_KI_DIV:
        {
          PID_SetKIDivisorPOW2(&PIDIdHandle_M1, regdata16);
          break;
        }

        case MC_REG_I_D_KD_DIV:
        {
          PID_SetKDDivisorPOW2(&PIDIdHandle_M1, regdata16);
          break;
        }

        case MC_REG_I_Q_KP_DIV:
        {
          PID_SetKPDivisorPOW2(&PIDIqHandle_M1, regdata16);
          break;
        }

        case MC_REG_I_Q_KI_DIV:
        {
          PID_SetKIDivisorPOW2(&PIDIqHandle_M1, regdata16);
          break;
        }

        case MC_REG_I_Q_KD_DIV:
        {
          PID_SetKDDivisorPOW2(&PIDIqHandle_M1, regdata16);
          break;
        }

        default:
        {
          retVal = MCP_ERROR_UNKNOWN_REG;
          break;
        }
      }
      *size = 2;
      break;
    }

    case TYPE_DATA_32BIT:
    {
      uint32_t regdata32 = *(uint32_t *)data; //cstat !MISRAC2012-Rule-11.3

      switch (regID)
      {
        case MC_REG_FAULTS_FLAGS:
        case MC_REG_SPEED_MEAS:
        {
          retVal = MCP_ERROR_RO_REG;
          break;
        }

        case MC_REG_SPEED_REF:
        {
          MCI_ExecSpeedRamp(pMCIN,((((int16_t)regdata32) * ((int16_t)SPEED_UNIT)) / (int16_t)U_RPM), 0);
          break;
        }

        default:
        {
          retVal = MCP_ERROR_UNKNOWN_REG;
          break;
        }
      }
      *size = 4;
      break;
    }

    case TYPE_DATA_STRING:
    {
      const char_t *charData = (const char_t *)data;
      char_t *dummy = (char_t *)data;
      retVal = MCP_ERROR_RO_REG;
      /* Used to compute String length stored in RXBUFF even if Reg does not exist */
      /* It allows to jump to the next command in the buffer */
      (void)RI_MovString(charData, dummy, size, dataAvailable);
      break;
    }

    case TYPE_DATA_RAW:
    {
      uint16_t rawSize = *(uint16_t *)data; //cstat !MISRAC2012-Rule-11.3
      /* The size consumed by the structure is the structure size + 2 bytes used to store the size */
      *size = rawSize + 2U;
      uint8_t *rawData = data; /* rawData points to the first data (after size extraction) */
      rawData++;
      rawData++;

      if (*size > (uint16_t)dataAvailable)
      {
        /* The decoded size of the raw structure can not match with transmitted buffer, error in buffer
           construction */
        *size = 0;
        retVal = MCP_ERROR_BAD_RAW_FORMAT; /* This error stop the parsing of the CMD buffer */
      }
      else
      {
        switch (regID)
        {
          case MC_REG_APPLICATION_CONFIG:
          case MC_REG_MOTOR_CONFIG:
          case MC_REG_GLOBAL_CONFIG:
          case MC_REG_FOCFW_CONFIG:
          {
            retVal = MCP_ERROR_RO_REG;
            break;
          }

          case MC_REG_SPEED_RAMP:
          {
            int32_t rpm;
            uint16_t duration;

            rpm = *(int32_t *)rawData; //cstat !MISRAC2012-Rule-11.3
            duration = *(uint16_t *)&rawData[4]; //cstat !MISRAC2012-Rule-11.3
            MCI_ExecSpeedRamp(pMCIN, (int16_t)((rpm * SPEED_UNIT) / U_RPM), duration);
            break;
          }

          case MC_REG_TORQUE_RAMP:
          {
            uint32_t torque;
            uint16_t duration;

            torque = *(uint32_t *)rawData; //cstat !MISRAC2012-Rule-11.3
            duration = *(uint16_t *)&rawData[4]; //cstat !MISRAC2012-Rule-11.3
            MCI_ExecTorqueRamp(pMCIN, (int16_t)torque, duration);
            break;
          }

          case MC_REG_CURRENT_REF:
          {
            qd_t currComp;
            currComp.q = *((int16_t *) rawData); //cstat !MISRAC2012-Rule-11.3
            currComp.d = *((int16_t *) &rawData[2]); //cstat !MISRAC2012-Rule-11.3
            MCI_SetCurrentReferences(pMCIN, currComp);
            break;
          }
          case MC_REG_ASYNC_UARTA:
          {
            retVal =  MCPA_cfgLog (&MCPA_UART_A, rawData);
            break;
          }

          default:
          {
            retVal = MCP_ERROR_UNKNOWN_REG;
            break;
          }
        }
      }
      break;
    }

    default:
    {
      retVal = MCP_ERROR_BAD_DATA_TYPE;
      *size =0; /* From this point we are not able anymore to decode the RX buffer */
      break;
    }
  }
  return (retVal);
}

uint8_t RI_GetRegisterGlobal(uint16_t regID,uint8_t typeID,uint8_t * data,uint16_t *size,int16_t freeSpace){
    uint8_t retVal = MCP_CMD_OK;
    switch (typeID)
    {
      case TYPE_DATA_8BIT:
      {
        if (freeSpace > 0)
        {
          switch (regID)
          {
            default:
            {
              retVal = MCP_ERROR_UNKNOWN_REG;
              break;
            }
          }
          *size = 1;
        }
        else
        {
          retVal = MCP_ERROR_NO_TXSYNC_SPACE;
        }
        break;
      }

      case TYPE_DATA_16BIT:
      {
        if (freeSpace >= 2)
        {
          switch (regID)
          {
            case MC_REG_DAC_USER1:
            case MC_REG_DAC_USER2:
              break;

            default:
            {
              retVal = MCP_ERROR_UNKNOWN_REG;
              break;
            }
          }
          *size = 2;
        }
        else
        {
          retVal = MCP_ERROR_NO_TXSYNC_SPACE;
        }
        break;
      }

      case TYPE_DATA_32BIT:
      {
        if (freeSpace >= 4)
        {
          switch (regID)
          {

            default:
            {
              retVal = MCP_ERROR_UNKNOWN_REG;
              break;
            }
          }
          *size = 4;
        }
        else
        {
          retVal = MCP_ERROR_NO_TXSYNC_SPACE;
        }
        break;
      }

      case TYPE_DATA_STRING:
      {
        char_t *charData = (char_t *)data;
        switch (regID)
        {
          case MC_REG_FW_NAME:
            retVal = RI_MovString (FIRMWARE_NAME ,charData, size, freeSpace);
            break;

          case MC_REG_CTRL_STAGE_NAME:
          {
            retVal = RI_MovString (CTL_BOARD ,charData, size, freeSpace);
            break;
          }
          default:
          {

            retVal = MCP_ERROR_UNKNOWN_REG;
            *size= 0 ; /* */

            break;
          }
        }
        break;

      }
      case TYPE_DATA_RAW:
      {
        /* First 2 bytes of the answer is reserved to the size */
        uint16_t *rawSize = (uint16_t *)data; //cstat !MISRAC2012-Rule-11.3
        uint8_t * rawData = data;
        rawData++;
        rawData++;

        switch (regID)
        {
          case MC_REG_GLOBAL_CONFIG:
          {
            *rawSize = (uint16_t)sizeof(GlobalConfig_reg_t);
            if (((*rawSize) + 2U) > (uint16_t)freeSpace)
            {
              retVal = MCP_ERROR_NO_TXSYNC_SPACE;
            }
            else
            {
              (void)memcpy(rawData, &globalConfig_reg, sizeof(GlobalConfig_reg_t));
            }
            break;
          }
          case MC_REG_ASYNC_UARTA:
          case MC_REG_ASYNC_UARTB:
          case MC_REG_ASYNC_STLNK:
          default:
          {
            retVal = MCP_ERROR_UNKNOWN_REG;
            break;
          }
        }

        /* Size of the answer is size of the data + 2 bytes containing data size */
        *size = (*rawSize) + 2U;
        break;
      }

      default:
      {
        retVal = MCP_ERROR_BAD_DATA_TYPE;
        break;
      }
    }
  return (retVal);
}

  uint8_t RI_GetRegisterMotor1(uint16_t regID,uint8_t typeID,uint8_t * data,uint16_t *size,int16_t freeSpace) {
    uint8_t retVal = MCP_CMD_OK;
    uint8_t motorID=0;
    MCI_Handle_t *pMCIN = &Mci[motorID];
    BusVoltageSensor_Handle_t* BusVoltageSensor= &BusVoltageSensor_M1._Super;
    switch (typeID)
    {
      case TYPE_DATA_8BIT:
      {
        if (freeSpace > 0)
        {
          switch (regID)
          {
            case MC_REG_STATUS:
            {
              *data = (uint8_t)MCI_GetSTMState(pMCIN);
              break;
            }

            case MC_REG_SECTOR:
            {
              *data = pMCIN->pPWM->Sector;
              break;
            }

            case MC_REG_CONTROL_MODE:
            {
              *data = (uint8_t)MCI_GetControlMode(pMCIN);
              break;
            }

            default:
            {
              retVal = MCP_ERROR_UNKNOWN_REG;
              break;
            }
          }
          *size = 1;
        }
        else
        {
          retVal = MCP_ERROR_NO_TXSYNC_SPACE;
        }
        break;
      }

      case TYPE_DATA_16BIT:
      {
        uint16_t *regdataU16 = (uint16_t *)data; //cstat !MISRAC2012-Rule-11.3
        int16_t *regdata16 = (int16_t *) data; //cstat !MISRAC2012-Rule-11.3

        if (freeSpace >= 2)
        {
          switch (regID)
          {

            case MC_REG_SPEED_KP:
            {
              *regdata16 = PID_GetKP(&PIDSpeedHandle_M1);
              break;
            }

            case MC_REG_SPEED_KI:
            {
              *regdata16 = PID_GetKI(&PIDSpeedHandle_M1);
              break;
            }

            case MC_REG_SPEED_KD:
            {
              *regdata16 = PID_GetKD(&PIDSpeedHandle_M1);
              break;
            }

            case MC_REG_I_Q_KP:
            {
              *regdata16 = PID_GetKP(&PIDIqHandle_M1);
              break;
            }

            case MC_REG_I_Q_KI:
            {
              *regdata16 = PID_GetKI(&PIDIqHandle_M1);
              break;
            }

            case MC_REG_I_Q_KD:
            {
              *regdata16 = PID_GetKD(&PIDIqHandle_M1);
              break;
            }

            case MC_REG_I_D_KP:
            {
              *regdata16 = PID_GetKP(&PIDIdHandle_M1);
              break;
            }

            case MC_REG_I_D_KI:
            {
              *regdata16 = PID_GetKI(&PIDIdHandle_M1);
              break;
            }

            case MC_REG_I_D_KD:
            {
              *regdata16 = PID_GetKD(&PIDIdHandle_M1);
              break;
            }

            case MC_REG_BUS_VOLTAGE:
            {
              *regdataU16 = VBS_GetAvBusVoltage_V(BusVoltageSensor);
              break;
            }

            case MC_REG_HEATS_TEMP:
            {
              *regdata16 = NTC_GetAvTemp_C(&TempSensor_M1);
              break;
            }

            case MC_REG_I_A:
            {
              *regdata16 = MCI_GetIab(pMCIN).a;
              break;
            }

            case MC_REG_I_B:
            {
              *regdata16 = MCI_GetIab(pMCIN).b;
              break;
            }

            case MC_REG_I_ALPHA_MEAS:
            {
              *regdata16 = MCI_GetIalphabeta(pMCIN).alpha;
              break;
            }

            case MC_REG_I_BETA_MEAS:
            {
              *regdata16 = MCI_GetIalphabeta(pMCIN).beta;
              break;
            }

            case MC_REG_I_Q_MEAS:
            {
              *regdata16 = MCI_GetIqd(pMCIN).q;
              break;
            }

            case MC_REG_I_D_MEAS:
            {
              *regdata16 = MCI_GetIqd(pMCIN).d;
              break;
            }

            case MC_REG_I_Q_REF:
            {
              *regdata16 = MCI_GetIqdref(pMCIN).q;
              break;
            }

            case MC_REG_I_D_REF:
            {
              *regdata16 = MCI_GetIqdref(pMCIN).d;
              break;
            }

            case MC_REG_V_Q:
            {
              *regdata16 = MCI_GetVqd(pMCIN).q;
              break;
            }

            case MC_REG_V_D:
            {
              *regdata16 = MCI_GetVqd(pMCIN).d;
              break;
            }

            case MC_REG_V_ALPHA:
            {
              *regdata16 = MCI_GetValphabeta(pMCIN).alpha;
              break;
            }

            case MC_REG_V_BETA:
            {
              *regdata16 = MCI_GetValphabeta(pMCIN).beta;
              break;
            }

            case MC_REG_ENCODER_EL_ANGLE:
            {
              *regdata16 = SPD_GetElAngle ((SpeednPosFdbk_Handle_t*) &ENCODER_M1); //cstat !MISRAC2012-Rule-11.3
              break;
            }

            case MC_REG_ENCODER_SPEED:
            {
              *regdata16 = SPD_GetS16Speed ((SpeednPosFdbk_Handle_t*) &ENCODER_M1); //cstat !MISRAC2012-Rule-11.3
              break;
            }

            case MC_REG_DAC_USER1:
            case MC_REG_DAC_USER2:
              break;

            case MC_REG_SPEED_KP_DIV:
            {
              *regdataU16 = (uint16_t)PID_GetKPDivisorPOW2(&PIDSpeedHandle_M1);
              break;
            }

            case MC_REG_SPEED_KI_DIV:
            {
              *regdataU16 = (uint16_t)PID_GetKIDivisorPOW2(&PIDSpeedHandle_M1);
              break;
            }

            case MC_REG_SPEED_KD_DIV:
            {
              *regdataU16 = PID_GetKDDivisorPOW2(&PIDSpeedHandle_M1);
              break;
            }
            case MC_REG_I_D_KP_DIV:
            {
              *regdataU16 = PID_GetKPDivisorPOW2(&PIDIdHandle_M1);
              break;
            }

            case MC_REG_I_D_KI_DIV:
            {
              *regdataU16 = PID_GetKIDivisorPOW2(&PIDIdHandle_M1);
              break;
            }

            case MC_REG_I_D_KD_DIV:
            {
              *regdataU16 = PID_GetKDDivisorPOW2(&PIDIdHandle_M1);
              break;
            }

            case MC_REG_I_Q_KP_DIV:
            {
              *regdataU16 = PID_GetKPDivisorPOW2(&PIDIqHandle_M1);
              break;
            }

            case MC_REG_I_Q_KI_DIV:
            {
              *regdataU16 = PID_GetKIDivisorPOW2(&PIDIqHandle_M1);
              break;
            }

            case MC_REG_I_Q_KD_DIV:
            {
              *regdataU16 = PID_GetKDDivisorPOW2(&PIDIqHandle_M1);
              break;
            }

            default:
            {
              retVal = MCP_ERROR_UNKNOWN_REG;
              break;
            }
          }
          *size = 2;
        }
        else
        {
          retVal = MCP_ERROR_NO_TXSYNC_SPACE;
        }
        break;
      }

      case TYPE_DATA_32BIT:
      {
        uint32_t *regdataU32 = (uint32_t *)data; //cstat !MISRAC2012-Rule-11.3
        int32_t *regdata32 = (int32_t *)data; //cstat !MISRAC2012-Rule-11.3

        if (freeSpace >= 4)
        {
          switch (regID)
          {
            case MC_REG_FAULTS_FLAGS:
            {
              *regdataU32 = MCI_GetFaultState(pMCIN);
              break;
            }
            case MC_REG_SPEED_MEAS:
            {
              *regdata32 = (((int32_t)MCI_GetAvrgMecSpeedUnit(pMCIN) * U_RPM) / SPEED_UNIT);
              break;
            }

            case MC_REG_SPEED_REF:
            {
              *regdata32 = (((int32_t)MCI_GetMecSpeedRefUnit(pMCIN) * U_RPM) / SPEED_UNIT);
              break;
            }

            case MC_REG_MOTOR_POWER:
            {
              FloatToU32 ReadVal; //cstat !MISRAC2012-Rule-19.2
              ReadVal.Float_Val = PQD_GetAvrgElMotorPowerW(pMPM[M1]);
              *regdataU32 = ReadVal.U32_Val; //cstat !UNION-type-punning
              break;
            }

            default:
            {
              retVal = MCP_ERROR_UNKNOWN_REG;
              break;
            }
          }
          *size = 4;
        }
        else
        {
          retVal = MCP_ERROR_NO_TXSYNC_SPACE;
        }
        break;
      }

      case TYPE_DATA_STRING:
      {
        char_t *charData = (char_t *)data;
        switch (regID)
        {
          case MC_REG_PWR_STAGE_NAME:
          {
            retVal = RI_MovString (PWR_BOARD_NAME[motorID], charData, size, freeSpace);
            break;
          }

          case MC_REG_MOTOR_NAME:
          {
            retVal = RI_MovString (MotorConfig_reg[motorID]->name ,charData, size, freeSpace);
            break;
          }

          default:
          {
            retVal = MCP_ERROR_UNKNOWN_REG;
            *size= 0 ; /* */
            break;
          }
        }
        break;
      }

      case TYPE_DATA_RAW:
      {
        /* First 2 bytes of the answer is reserved to the size */
        uint16_t *rawSize = (uint16_t *)data; //cstat !MISRAC2012-Rule-11.3
        uint8_t * rawData = data;
        rawData++;
        rawData++;

        switch (regID)
        {
          case MC_REG_APPLICATION_CONFIG:
          {
            *rawSize = (uint16_t)sizeof(ApplicationConfig_reg_t);
            if (((*rawSize) + 2U) > (uint16_t)freeSpace)
            {
              retVal = MCP_ERROR_NO_TXSYNC_SPACE;
            }
            else
            {
              ApplicationConfig_reg_t const *pApplicationConfig_reg = ApplicationConfig_reg[motorID];
              (void)memcpy(rawData, (const uint8_t *)pApplicationConfig_reg, sizeof(ApplicationConfig_reg_t));
            }
            break;
          }

          case MC_REG_MOTOR_CONFIG:
          {
            *rawSize = (uint16_t)sizeof(MotorConfig_reg_t);
            if (((*rawSize) + 2U) > (uint16_t)freeSpace)
            {
              retVal = MCP_ERROR_NO_TXSYNC_SPACE;
            }
            else
            {
              MotorConfig_reg_t const *pMotorConfig_reg = MotorConfig_reg[motorID];
              (void)memcpy(rawData, (const uint8_t *)pMotorConfig_reg, sizeof(MotorConfig_reg_t));
            }
            break;
          }

          case MC_REG_FOCFW_CONFIG:
          {
            *rawSize = (uint16_t)sizeof(FOCFwConfig_reg_t);
            if (((*rawSize) + 2U) > (uint16_t)freeSpace)
            {
              retVal = MCP_ERROR_NO_TXSYNC_SPACE;
            }
            else
            {
              FOCFwConfig_reg_t const *pFOCConfig_reg = FOCConfig_reg[motorID];
              (void)memcpy(rawData, (const uint8_t *)pFOCConfig_reg, sizeof(FOCFwConfig_reg_t));
            }

            break;
          }
          case MC_REG_SCALE_CONFIG:
          {
            *rawSize = 12;
            if ((*rawSize) +2U > (uint16_t)freeSpace)
            {
              retVal = MCP_ERROR_NO_TXSYNC_SPACE;
            }
            else
            {
              memcpy(rawData, &scaleParams_M1, sizeof(ScaleParams_t) );
            }
            break;
          }
          case MC_REG_SPEED_RAMP:
          {
            int32_t *rpm = (int32_t *)rawData; //cstat !MISRAC2012-Rule-11.3
            uint16_t *duration = (uint16_t *)&rawData[4]; //cstat !MISRAC2012-Rule-11.3
            *rpm = (((int32_t)MCI_GetLastRampFinalSpeed(pMCIN) * U_RPM) / (int32_t)SPEED_UNIT);
            *duration = MCI_GetLastRampFinalDuration(pMCIN);
            *rawSize = 6;
            break;
          }

          case MC_REG_TORQUE_RAMP:
          {
            int16_t *torque = (int16_t *)rawData; //cstat !MISRAC2012-Rule-11.3
            uint16_t *duration = (uint16_t *)&rawData[2]; //cstat !MISRAC2012-Rule-11.3

            *rawSize = 4;
            *torque = MCI_GetLastRampFinalTorque(pMCIN);
            *duration = MCI_GetLastRampFinalDuration(pMCIN) ;
            break;
          }

          case MC_REG_CURRENT_REF:
          {
            uint16_t *iqref = (uint16_t *)rawData; //cstat !MISRAC2012-Rule-11.3
            uint16_t *idref = (uint16_t *)&rawData[2]; //cstat !MISRAC2012-Rule-11.3

            *rawSize = 4;
            *iqref = (uint16_t)MCI_GetIqdref(pMCIN).q;
            *idref = (uint16_t)MCI_GetIqdref(pMCIN).d;
            break;
          }

          case MC_REG_ASYNC_UARTA:
          case MC_REG_ASYNC_UARTB:
          case MC_REG_ASYNC_STLNK:
          default:
          {
            retVal = MCP_ERROR_UNKNOWN_REG;
            break;
          }
        }

        /* Size of the answer is size of the data + 2 bytes containing data size */
        *size = (*rawSize) + 2U;
        break;
      }

      default:
      {
        retVal = MCP_ERROR_BAD_DATA_TYPE;
        break;
      }
    }
    return (retVal);
  }

uint8_t RI_MovString(const char_t *srcString, char_t *destString, uint16_t *size, int16_t maxSize)
{
  uint8_t retVal = MCP_CMD_OK;
  const char_t *tempsrcString = srcString;
  char_t *tempdestString = destString;
  *size= 1U ; /* /0 is the min String size */

  while ((*tempsrcString != (char_t)0) && (*size < (uint16_t)maxSize))
  {
    *tempdestString = *tempsrcString;
    tempdestString++;
    tempsrcString++;
    *size = *size + 1U;
  }

  if (*tempsrcString != (char_t)0)
  { /* Last string char must be 0 */
    retVal = MCP_ERROR_STRING_FORMAT;
  }
  else
  {
    *tempdestString = (int8_t)0;
  }
  return (retVal);
}

/************************ (C) COPYRIGHT 2026 STMicroelectronics *****END OF FILE****/
