JayChintala/1DOF-FOC-Force-Feedback/ESC_based/STM32/MCWorkbench/Src/hf_registers.c

/**
  ******************************************************************************
  * @file    hf_registers.c
  * @author  Motor Control SDK Team, ST Microelectronics
  * @brief   This file provides firmware functions that implement the handling
  * of registers access for the DAC and ASYNC protocol used in the High Frequency
  * Task.
  *
  *
  ******************************************************************************
  * @attention
  *
  * <h2><center>&copy; Copyright (c) 2026 STMicroelectronics.
  * All rights reserved.</center></h2>
  *
  * This software component is licensed by ST under Ultimate Liberty license
  * SLA0044, the "License"; You may not use this file except in compliance with
  * the License. You may obtain a copy of the License at:
  *                             www.st.com/SLA0044
  *
  ******************************************************************************
  */

#include "stdint.h"
#include "register_interface.h"
#include "mc_config.h"

uint8_t HF_GetIDSize(uint16_t dataID)
{
  uint8_t typeID = ((uint8_t)dataID) & TYPE_MASK;
  uint8_t result;

  switch (typeID)
  {
    case TYPE_DATA_8BIT:
    {
      result = 1;
      break;
    }

    case TYPE_DATA_16BIT:
    {
      result = 2;
      break;
    }

    case TYPE_DATA_32BIT:
    {
      result = 4;
      break;
    }

    default:
    {
      result=0;
      break;
    }
  }

  return (result);
}

__weak uint8_t HF_GetPtrReg(uint16_t dataID, void **dataPtr)
{

  uint8_t retVal = HF_CMD_OK;
  static uint16_t nullData16=0;

#ifdef NULL_PTR_CHECK_REG_INT
  if (MC_NULL == dataPtr)
  {
    retVal = HF_CMD_NOK;
  }
  else
  {
#endif

    MCI_Handle_t *pMCIN = &Mci[0];
    uint16_t regID = dataID & REG_MASK;
    uint8_t typeID = ((uint8_t)dataID) & TYPE_MASK;

    switch (typeID)
    {
      case TYPE_DATA_16BIT:
      {
        switch (regID)
        {
          case MC_REG_I_A:
          {
            *dataPtr = &(pMCIN->pFOCVars->Iab.a);
             break;
          }

          case MC_REG_I_B:
          {
            *dataPtr = &(pMCIN->pFOCVars->Iab.b);
            break;
          }

          case MC_REG_I_ALPHA_MEAS:
          {
            *dataPtr = &(pMCIN->pFOCVars->Ialphabeta.alpha);
            break;
          }

          case MC_REG_I_BETA_MEAS:
          {
            *dataPtr = &(pMCIN->pFOCVars->Ialphabeta.beta);
            break;
          }

          case MC_REG_I_Q_MEAS:
          {
            *dataPtr = &(pMCIN->pFOCVars->Iqd.q);
            break;
          }

          case MC_REG_I_D_MEAS:
          {
            *dataPtr = &(pMCIN->pFOCVars->Iqd.d);
            break;
          }

          case MC_REG_I_Q_REF:
          {
            *dataPtr = &(pMCIN->pFOCVars->Iqdref.q);
            break;
          }

          case MC_REG_I_D_REF:
          {
            *dataPtr = &(pMCIN->pFOCVars->Iqdref.d);
            break;
          }
          case MC_REG_OPENLOOP_EL_ANGLE:
          {
            *dataPtr = &((&VirtualSpeedSensorM1)->_Super.hElAngle);
            break;
          }

          case MC_REG_V_Q:
          {
            *dataPtr = &(pMCIN->pFOCVars->Vqd.q);
            break;
          }

          case MC_REG_V_D:
          {
            *dataPtr = &(pMCIN->pFOCVars->Vqd.d);
            break;
          }

          case MC_REG_V_ALPHA:
          {
            *dataPtr = &(pMCIN->pFOCVars->Valphabeta.alpha);
            break;
          }

          case MC_REG_V_BETA:
          {
            *dataPtr = &(pMCIN->pFOCVars->Valphabeta.beta);
            break;
          }

          case MC_REG_ENCODER_SPEED:
          {
            *dataPtr = &((&ENCODER_M1)->_Super.hAvrMecSpeedUnit);
            break;
          }

          case MC_REG_ENCODER_EL_ANGLE:
          {
            *dataPtr = &((&ENCODER_M1)->_Super.hElAngle);
            break;
          }

          default:
          {
            *dataPtr = &nullData16;
            retVal = HF_ERROR_UNKNOWN_REG;
            break;
          }
        }
        break;
      }

      default:
      {
        *dataPtr = &nullData16;
        retVal = HF_ERROR_UNKNOWN_REG;
        break;
      }
    }
#ifdef NULL_PTR_CHECK_REG_INT
  }
#endif
  return (retVal);
}

/************************ (C) COPYRIGHT 2026 STMicroelectronics *****END OF FILE****/
