JayChintala/1DOF-FOC-Force-Feedback/ESC_based/STM32/MCWorkbench/Inc/pwm_common.h

/**
  ******************************************************************************
  * @file    pwm_common.h
  * @author  Motor Control SDK Team, ST Microelectronics
  * @brief   This file contains all definitions and functions prototypes for the
  *          PWM & Current Feedback component of the Motor Control SDK.
  ******************************************************************************
  * @attention
  *
  * <h2><center>&copy; Copyright (c) 2026 STMicroelectronics.
  * All rights reserved.</center></h2>
  *
  * This software component is licensed by ST under Ultimate Liberty license
  * SLA0044, the "License"; You may not use this file except in compliance with
  * the License. You may obtain a copy of the License at:
  *                             www.st.com/SLA0044
  *
  ******************************************************************************
  * @ingroup pwm_curr_fdbk
  */

/* Define to prevent recursive inclusion -------------------------------------*/
#ifndef PWMNCOMMON_H
#define PWMNCOMMON_H

#ifdef __cplusplus
extern "C" {
#endif /* __cplusplus */

/* Includes ------------------------------------------------------------------*/
#include "mc_type.h"

/**
  * @brief  The maximum number of needed PWM cycles. verif?
  */
#define NB_CONVERSIONS 128u /* was 16u: offset calibration averaging; see FIRMWARE_CHANGES.txt CHANGE 3 */

/** @addtogroup MCSDK
  * @{
  */

/** @addtogroup ConvFOC
  * @{
  */

/** @addtogroup MCLLAPI
  * @{
  */

/** @addtogroup pwm_curr_fdbk
  * @{
  */

/* Exported defines ----------------------------------------------------------*/

/* Exported types ------------------------------------------------------------*/

/* Exported functions --------------------------------------------------------*/

/*
  *  Performs the start of all the timers required by the control.
  *  It uses TIM2 as a temporary timer to achieve synchronization between PWM signals.
  *  When this function is called, TIM1 and/or TIM8 must be in a frozen state
  *  with CNT, ARR, REP RATE and trigger correctly set (these settings are
  *  usually performed in the Init method accordingly with the configuration)
  */
void startTimers(void);

/*
  *   Waits for the end of the polarization. If the polarization exceeds
  *   the number of needed PWM cycles, it reports an error.
  */
void waitForPolarizationEnd(TIM_TypeDef *TIMx, uint16_t *SWerror, uint8_t repCnt, volatile uint8_t *cnt);
/**
  * @}
  */

/**
  * @}
  */

#ifdef __cplusplus
}
#endif /* __cpluplus */

#endif /* PWMNCOMMON_H */

/******************* (C) COPYRIGHT 2026 STMicroelectronics *****END OF FILE****/
