JayChintala/1DOF-FOC-Force-Feedback/ESC_based/software/plant_gain_test.py

"""
Plant gain (inertia) measurement -- how much acceleration each amp buys.

WHY THIS EXISTS
Every gain in teleop_test.py has been chosen by bench feel, and the two
useful designs left both need a NUMBER instead:

  - the achievable KV_SLOPE follows directly from the plant gain and the
    loop's phase lag: a velocity loop on this plant closes at
    omega_c = G * KV rad/s, and it goes unstable when omega_c * T ~ pi/2,
    so KV_max ~ pi / (2 * G * T). With T measured at ~4.5 ms, G is the
    only unknown left in that expression.
  - a disturbance observer that estimates how hard a hand is pushing on
    Motor B needs B's inertia explicitly: tau_ext = J * dw/dt - Kt * i,
    and 1/G is exactly that J/Kt ratio in the units this project uses
    (encoder counts, amps).

Regressing acceleration against current in the ordinary teleop logs gave
G = 1.3e6 to 4.6e6 cnt/s^2 per A with correlations of only 0.44-0.58 --
a factor of 3.5 of uncertainty, because in those logs a hand and a limit
cycle are both injecting torque the regression cannot see. This measures
it in open loop with nothing else touching the shaft.

METHOD
Bang-bang current around zero SPEED, not fixed-duration pulses. A step
would be unsafe: sign_check_test.py measured 0.15 A spinning a free motor
at ~20 rev/s, so a sustained level runs away.
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
