JayChintala/1DOF-FOC-Force-Feedback/(commit log)

2026-05-24 WIP: Added component symbols
    [1DOF_FOC_Force-Feedback.kicad_pcb, 1DOF_FOC_Force-Feedback.kicad_sch]
2026-05-25 Added second motor and BOM
    [1DOF_FOC_Force-Feedback.kicad_sch, BOM.xlsx]
2026-05-25 Renamed PCB folder to electrical-schematic
    [1DOF_FOC_Force-Feedback.kicad_pcb, 1DOF_FOC_Force-Feedback.kicad_sch]
2026-06-24 Created firmware folder
    [1DOF_FOC_Force-Feedback.kicad_sch, BOM.xlsx]
2026-06-25 Updated to use quadrature for encoders
    [1DOF_FOC_Force-Feedback.kicad_sch]
2026-06-25 Merged remote changes and added STM32
2026-06-25 Updated gitignore for STM32 build artifacts
2026-06-25 Added STM32 profile
2026-06-26 Track only STM32 config files
2026-06-26 Updated STM32 Motor Control Workbench Config enables spinning and speed sensing using quadrature
2026-06-27 Removed large generated STM32 SDK/IDE files from tracking
2026-06-27 Renamed STM32/v2 to STM32/MCWorkbench
2026-07-01 Changed perameters to remove choppyness from motor spinning
2026-07-01 Improved Torque output of motor
2026-07-03 updated motor specs
2026-07-04 WIP: CAN debugging session - TIM1 fix, GPIO states, can_driver.c (CAN RX still not working)
    [MCWorkbench.ioc, drive_parameters.h, main.h, mc_configuration_registers.c, mc_tasks.c, pmsm_motor_parameters.h, power_stage_parameters.h]
2026-07-04 Add CAN driver for teleioperaion: FDCAN RX (START/STOP/SET_IQ) and TX telemetry (IQ, elec angle, encoder count)
2026-07-04 Fix mc_app_hooks.c: remove duplicated/nested PostMediumFrequencyHook_M1 causing weak-declaration build error
    Full CAN loop verified working: START/STOP/SET_IQ RX, IQ/angle/encoder TX telemetry, torque scaling, encoder direction all confirmed on bench.
    [MCWorkbench.ioc]
2026-07-06 updated to accurate encoder pulse number per revolution
2026-07-08 WIP: torque mode change, FDCAN lost from .ioc (pre-restore checkpoint)
2026-07-08 Restore FDCAN1 config, re-apply torque mode, fix mc_app_hooks CAN calls, clean up can_driver.c debug TX
    [MCWorkbench.ioc, main.h, mc_tasks.c]
2026-07-09 Python scripts for tuning PID loop
2026-07-12 Validate ESC2 multi-node CAN bring-up, confirm sign convention on both motors
2026-07-12 Track .cproject/.project/launch configs; fixes Debug_ESC2 build config and launch type from being lost on fresh clone
2026-08-22 Track can_driver.c/.h: gitignore rule for Workbench-generated files was also excluding hand-written CAN code
    The blanket ignore for MCWorkbench/Src|Inc (meant for regenerable
    Workbench output) had no way to except individual files since a bare
    directory-slash pattern stops git from traversing into it at all.
    Switched to the dir/* form (matching the STM32CubeIDE/* pattern below
    it) so the can_driver.c/.h exceptions actually take effect. These files
    implement the hand-built CAN protocol and were previously untracked
    with zero version-control protection.
2026-08-23 TEST: raise current-sensing gain 8x -> 16x (untested, not yet built/flashed)
    Hand-edited (not regenerated from MCWorkbench, to avoid wiping the CAN
    integration) four coordinated values to improve current-sensing ADC
    resolution: OPAMP PGA gain enum (main.c), AMPLIFICATION_GAIN
    (power_stage_parameters.h), DAC_OCP_Threshold rescaled x2 to preserve
    the physical overcurrent trip point (mc_parameters.c), and
    PID_TORQUE/FLUX_KP/KI_DEFAULT rescaled /2 to preserve current-loop
    bandwidth (drive_parameters.h).
    Not yet built, flashed, or verified on hardware. See
    gentle-sparking-comet plan notes for the verification steps still
    needed: power-cycle after flashing, re-run iq_readback_probe.py and
    compare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
    [drive_parameters.h, power_stage_parameters.h]
2026-08-25 Add MC_REG_SECTOR diagnostic register for sector/Iq spike correlation
    Exposes pPWM->Sector as a read-only 8-bit register (ID 38) so
    MCWorkbench can log/plot PWM sector alongside Iq to check whether
    current-reconstruction spikes cluster at sector boundaries.
2026-08-27 Fix ESC2 CAN telemetry dropouts: enable FDCAN AutoRetransmission
    FDCAN AutoRetransmission was disabled (sets CCCR.DAR), so any single
    lost-arbitration attempt permanently dropped the frame instead of the
    hardware auto-retrying like normal CAN. Since ESC1's arbitration IDs
    (0x010/0x013/0x014) are always numerically lower than ESC2's
    (0x030/0x033/0x034), ESC2 lost arbitration on every simultaneous TX and,
    with retransmission disabled, those frames were gone for good -- this
    was the root cause of the ~1.4s telemetry dropout gaps observed on ESC2
    in candump captures while ESC1 stayed gap-free. Confirmed on hardware:
    this change stops the CAN dropouts on ESC2.
    Also check the return value of each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
    [can_driver.c]
2026-08-27 Move ad-hoc test scripts into software/diagnostics/, ignore generated logs
    Groups the one-off Motor2/force-mirror diagnostic scripts together instead
    of mixing them with the main test suite; adds a spin_motor2.py helper.
    Also stop tracking logs/, software/logs/, and software/__pycache__/ since
    these are regenerated CSV/PNG/bytecode output, not source.
2026-08-27 Add torque-tracking test and plotting support; probe Motor 2 instead
    torque_tracking_test.py drives open-loop Iq staircases and logs
    tracking error, velocity, and IQ_READBACK staleness; plot_run.py gains
    a matching 4-panel plotter, auto-detected from the CSV header.
    iq_readback_probe.py now points at Motor 2 (NODE_BASE_M1 = 0x020).
    [iq_readback_probe.py, plot_run.py, torque_tracking_test.py]
2026-08-27 Add CSV logging/plotting to iq_readback_probe.py; add raw+median-filtered Iq to torque_tracking_test.py
    iq_readback_probe.py now logs every sample and plots it via plot_run.py
    (new plot_iq_probe_log), matching the other diagnostic scripts -- the
    age panel made an intermittent ~1.4s IQ_READBACK stall on ESC2
    (CAN arbitration starvation against ESC1) visible for the first time.
    torque_tracking_test.py now runs IQ_READBACK through a 3-tap causal
    median filter and reports/logs/plots both the raw and filtered signal
    separately, so filtering noise out of the tracking-error/PASS-FAIL
    report doesn't hide what the raw sensor read.
    [iq_readback_probe.py, plot_run.py, torque_tracking_test.py]
2026-08-30 updated the gitignore to include all .h and .c files in SRC and INC folders
    [main_diff.txt]
2026-08-31 working on reducing oscillation from Motor 1 during teleop
    [teleop_test.py]
2026-08-31 removed oscillation, bringing back up the current ramp
    [teleop_test.py]
2026-08-31 Force based teleoperation klinda works. It is still kinda grindy, and very reactive to vibrations, but is best so far
    [can_interface.py, plant_gain_test.py, plot_run.py, telemetry_rate_probe.py, teleop_test.py]
2026-09-23 CAN: merge telemetry into one frame, timestamp at source, fix IRQ priority
    Telemetry: IQ_READBACK/IQ_MEAN/ELEC_ANGLE/ENC_COUNT collapse into a single 8-byte TELEM frame at base+0x012 (float32 Iq, uint16 encoder, uint16 MCU microsecond clock). Two motors at 1 kHz go from 6000 frames/s to 2000. The electrical angle, Iq EWMA and Iq boxcar mean are no longer sent -- nothing on the Pi read them. Iq and position now share one timestamp by construction, removing an unbounded skew. New ID rather than a reused one so a half-flashed bus goes silent instead of decoding garbage.
    Timestamp: DWT cycle counter gives a uint16 microsecond field in the payload, so dt is a property of the MCU clock and veloci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
    [MCWorkbench.ioc, can_driver.c, can_interface.py, encoder_resolution_check.py, telemetry_rate_probe.py]
2026-10-06 Initial Commit of ESC based firmware for faster teleop
    [main_diff.txt]
2026-10-21 ESC_based: Phase A diagnostics and Phase B host work, with test log/handoff
    Runs the sensorless force-feedback plan against the ESC_based firmware and
    records every step in ESC_based/software/TEST_LOG.md (TL;DR, firmware
    change list for the dev machine, and a resume-here handoff).
    Phase A tooling: bus_check, zero_iq_check (re-aligns after an ESC reset),
    ported teleop_test/plot_run/plant_gain_test (resend SET_IQ every tick,
    mcu_time_us timing), spin_test (host PI velocity loop), and analysis
    scripts for noise, ripple and the command path.
    Phase B, all behind flags whose defaults reproduce the original teleop:
    - can_interface: pair_dbg option so every TELEM frame is queued on arrival
    - teleo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
2026-10-25 ESC_based: B4 verified, host-stall diagnosis, feasibility check, firmware notes
    - FIRMWARE_CHANGES.txt: self-contained dev-machine instructions for B4
    (TELEM sends the 1 ms mean of Iq) and the 200 -> 20 ms direct-mode host
    timeout; B5 clamp dropped by user decision.
    - TEST_LOG.md: RT-priority fix for the CAN RX thread (limits.d rtprio)
    verified; remaining main-loop stalls traced to SD-card write stalls
    (deferred, must fix before C3); offline feasibility check (free floor
    34-44 mA vs contact 300-1000 mA; 3 ms current/velocity alignment);
    timeline to the goal; B4 PASS after flashing (Iq noise 9.7x lower,
    step delay unchanged, 247 Hz peak reduced but not gone).
    - feasibility.py, s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
2026-10-26 ESC_based: B7 calibration, Phase C data session and C1 offline (Gate A pass)
    - B7: Kt = 64.6 mN m/A from a rigid 160 mm press (levels 1-6, R^2 0.996,
    -2 % vs nominal); 4 cm rerun confirms the scaling; motor mount found to
    move under load.
    - Latched-fault and simultaneous-ESC-reset findings logged (shared power).
    - First post-B4 contact data (free, rigid presses, rigid taps, foam), logged
    to RAM to avoid SD stalls.
    - c1_eval.py: follower external-torque estimate on that data. Free floor
    10.3 mA (gentle motion), static error <= 2.8 %, sign convention settled,
    rigid >= ~6 N/mm vs foam ~0.3 N/mm (quasi-static).
2026-10-26 ESC_based: C2 shadow estimator, new arm re-identified, follower model file
    - teleop_test.py: TELEOP_SHADOW_TAU_ENV (live follower external-torque
    estimate, logged only) and TELEOP_FOLLOWER_MODEL (fitted G + friction +
    gravity); contact radius 75.7 mm for the 3D-printed arm.
    - fit_follower_model.py + follower_model_arm3d.json: G = 3.85e6 (R^2 0.93)
    for the new arm; free floor 23 mA held-out (Gate A) on vigorous motion.
    - plant_id.py: limited-range chirp identification; validated in
    simulation but unreliable with the follower's stiction (documented).
    - TEST_LOG.md: C2 chopstick FAIL diagnosis (11x inertia, hot-glue
    compliance), new-arm identification and live-path verification.
    Co-A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
2026-10-26 ESC_based: C2 live PASS with the fitted follower model (free 19.1 mA, static <= 5 %)
2026-10-26 ESC_based: C3 prep - RAM log dir (SD-stall fix), tau_env felt-force switch with K_F and dead band
2026-10-26 ESC_based: C3 damping step 3 oscillated (stop); operating point K_F 1.0, KB_DAMP 0.5e-5; current ceiling ~0.8 A
2026-10-26 ESC_based: C3 conclusion - operating point K_F 1.0, KB_DAMP 0.35e-5 (free 18.7 mA, tap rise 4 ms)
2026-10-26 ESC_based: resume-here update at end of C3; gearbox vs transparency design note
2026-10-26 ESC_based: note 0.8 A is the motor's thermal rating (user)
2026-10-29 ESC_based: contact spring, leader ripple calibration, force calibration, firmware notes
    - contact_spring.py + TELEOP_HOLD_*: contact-latched spring fixes the
    fading sustained holds (ramp-in 0.3 s); TELEOP_IQ1_MAX_A flag
    - Leader friction/ripple: breakaway_test.py, friction_map.py,
    leader_comp.py (+ leader_comp_B.json), in-session leader_cal.py
    (TELEOP_LEADER_CAL, TELEOP_LEADER_WARMUP_S), cal_repeat.py
    - hold_eval.py, hold_sim.py, plot_reference.py (reference graph)
    - b7_force_cal.py --log; tau_env_N and plots use the scale-measured
    1.044 N/A
    - FIRMWARE_CHANGES.txt: CHANGE 3 status, CHANGE 4-6 (future): offsets/
    NTC/Vqd diagnostic frames, switching + per-path offset calibration,
    O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
2026-10-29 ESC_based: firmware round 4-6 (two phases), CALIB/DIAG frame layouts and Pi parsers
    - FIRMWARE_CHANGES.txt: STATUS for this round (phase 1 report, phase 2
    implement), CHANGE 4 frame layouts fixed (CALIB 0x113/0x133, DIAG
    0x114/0x134), angle-dependent breakdown evidence in CHANGE 5
    - can_interface.py: parse CALIB and DIAG (get_diag, drain_diag_history)
    - TEST_LOG.md: stall-step angle map, firmware round prep
2026-10-29 ESC_based firmware: CHANGES 3-6 (offset averaging, CALIB/DIAG frames, switching offset calibration, OCP revert)
    CHANGE 3: NB_CONVERSIONS 16 -> 128 (already flashed 2026-10-26, now committed).
    CHANGE 4 (CAN_DIAG_FRAMES, default 1): CALIB 0x113/0x133 (phase offsets
    incl. phase-C ch18) and DIAG 0x114/0x134 (Vqd, read-path sector, flags,
    board NTC), 10 Hz each on separate ticks. DIAG snapshot taken at 16 kHz in
    mc_tasks_foc.c USER CODE blocks.
    CHANGE 5 (OFFSET_CALIB_SWITCHING, OFFSET_CALIB_CH18, default 1): strong
    overrides of the __weak R3_2_CurrentReadingPolarization and
    R3_2_GetPhaseCurrents in Application/User/offset_calib.c (MCSDK copy
    untouched). Calibrates with the bridge switching at 5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
2026-10-29 ESC_based firmware: CHANGE 7 (runtime Tafter via SET_PARAM, DIAG RUN-only flags, DIAG2 frame)
    7(a) SAMPLING_TAFTER_RUNTIME (default 1): Tafter is a RAM variable set by
    CAN SET_PARAM base+0x007 (DLC 5: u8 id, i32 LE; id 1 = Tafter counts,
    400..2040, any state). R3_2_Params_t is a "typedef const struct", so the
    MCSDK sampling routine is copied into Application/User/sampling_tafter.c
    reading the RAM Tafter and installed as pFctSetADCSampPointSectX in
    mc_config.c (hand edit). CircleLimitationM1.MaxModule/MaxVd are re-derived
    from Tafter so the natural-path sample stays in the mid leg's window
    (807 -> unchanged 89 %, 1360 -> ~85 %, 2040 -> ~70.5 %). Rejects are
    counted; DIAG flags bit6 = rejected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
2026-10-30 ESC_based: Tafter 400 default, leader contact spring, follower position coupling
    - CHANGE 7 verified on hardware: raising Tafter makes the >0.55 A current
    breakdown worse; Tafter 400 fixes it (within 2 % to 0.8 A at a bad and a
    good angle; blind A/B teleop preferred over 807). can_interface sends
    DEFAULT_TAFTER (400, env ESC_TAFTER) before every START.
    - tafter_sweep.py: live electrical-angle guide (--window) before START,
    per-level angle column, restores the default Tafter.
    - Leader contact spring on the hold latch (TELEOP_LEADER_K, _K_MAX_A,
    _CONTACT_DAMP): leader travel into a rigid object 34 deg -> ~2-3 deg.
    - Slipping follower position coupling (TELEOP_POS_K, TELEOP_POS_WINDOW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
