JayChintala/1DOF-FOC-Force-Feedback/(notices)

Notices in the files:
ESC_based/STM32/MCWorkbench/Inc/main.h:
This software is licensed under terms that can be found in the LICENSE file
